SDupuie/esp32-weather-alarm-clock/docs/orbit-case/Orbit-Back-Mount-Mockup.png

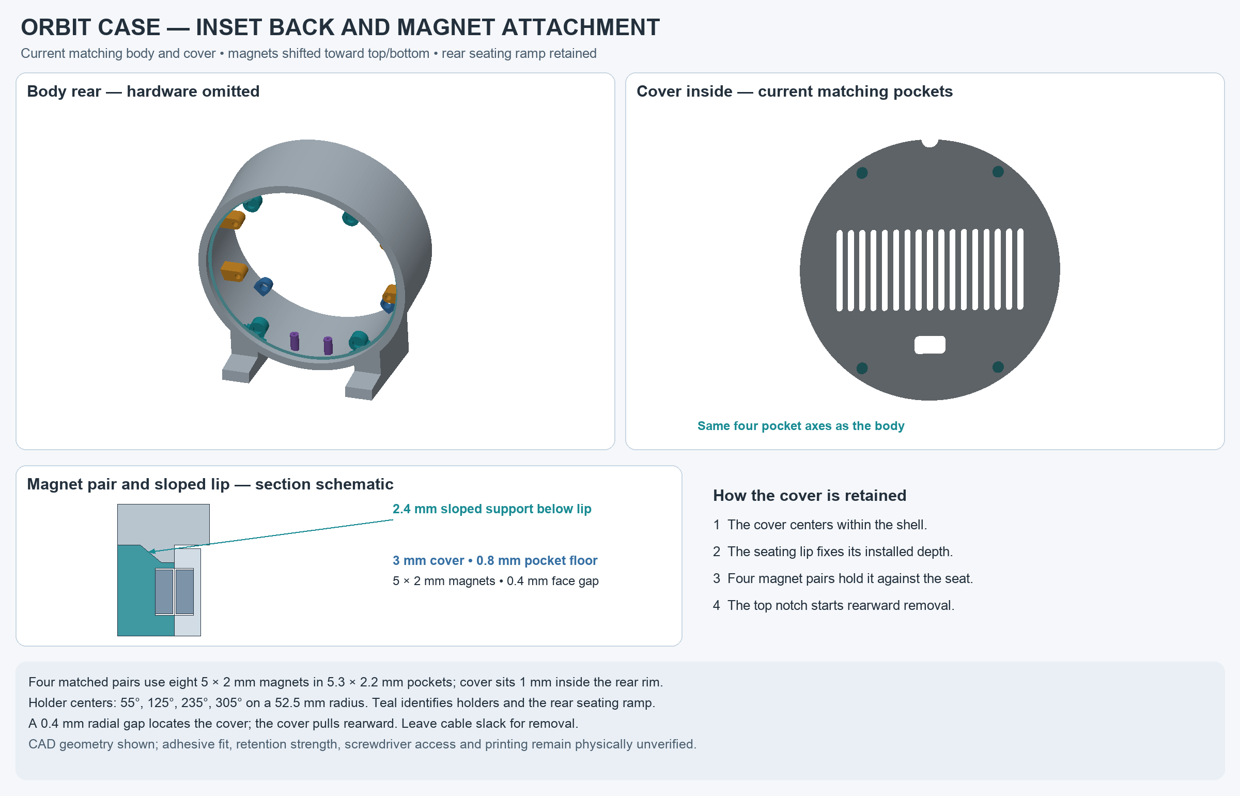
docs/orbit-case/Orbit-Back-Mount-Mockup.png
