SDupuie/esp32-weather-alarm-clock/docs/orbit-case/Orbit-Leg-Rear-Clearance-Detail.png

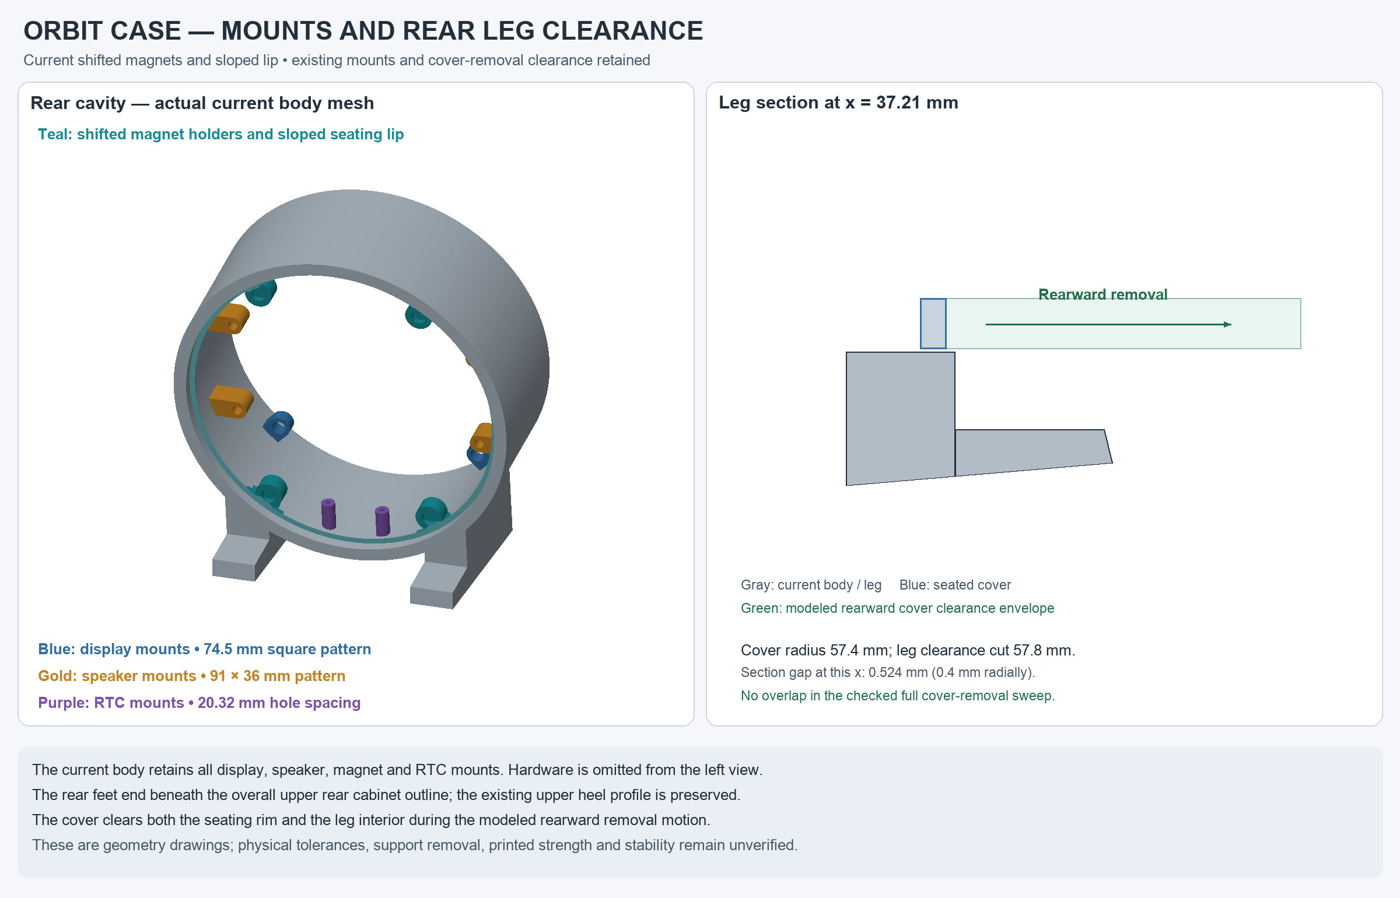
docs/orbit-case/Orbit-Leg-Rear-Clearance-Detail.png
