SDupuie/esp32-weather-alarm-clock/docs/orbit-case/Orbit-Magnet-Access-Detail.png

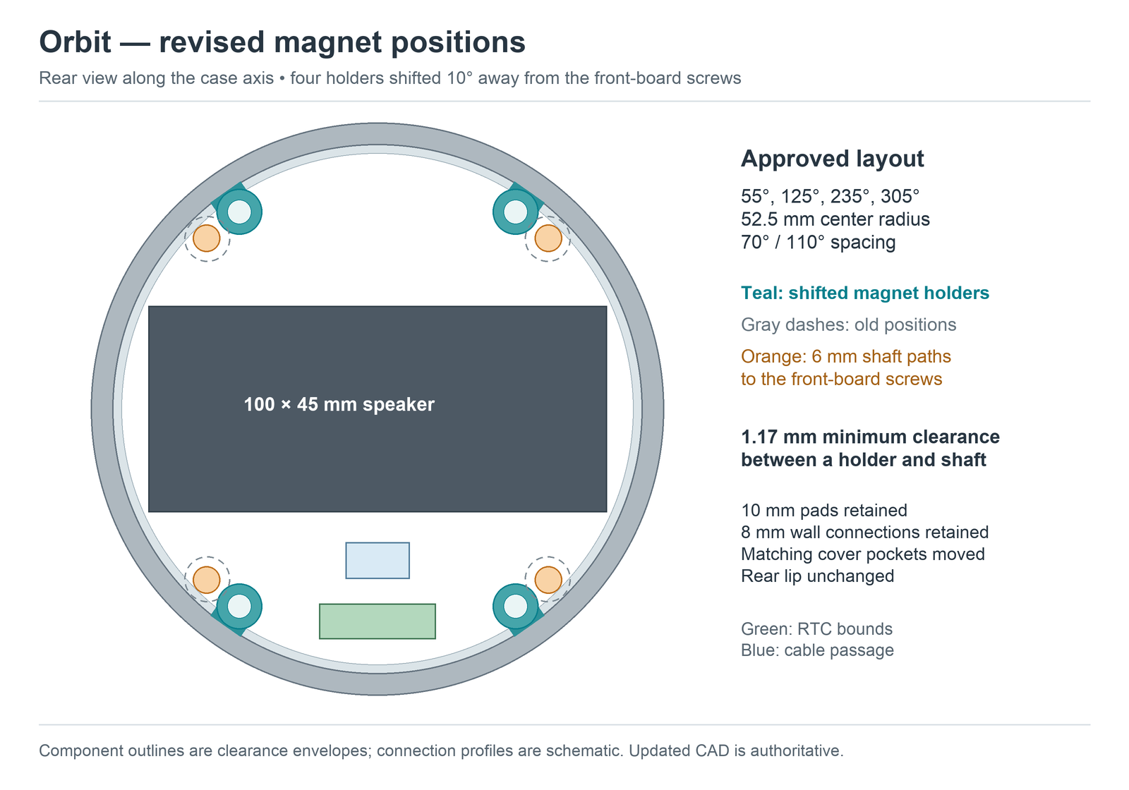
docs/orbit-case/Orbit-Magnet-Access-Detail.png
