SDupuie/esp32-weather-alarm-clock/docs/orbit-case/Orbit-Magnet-Pad-Detail.png

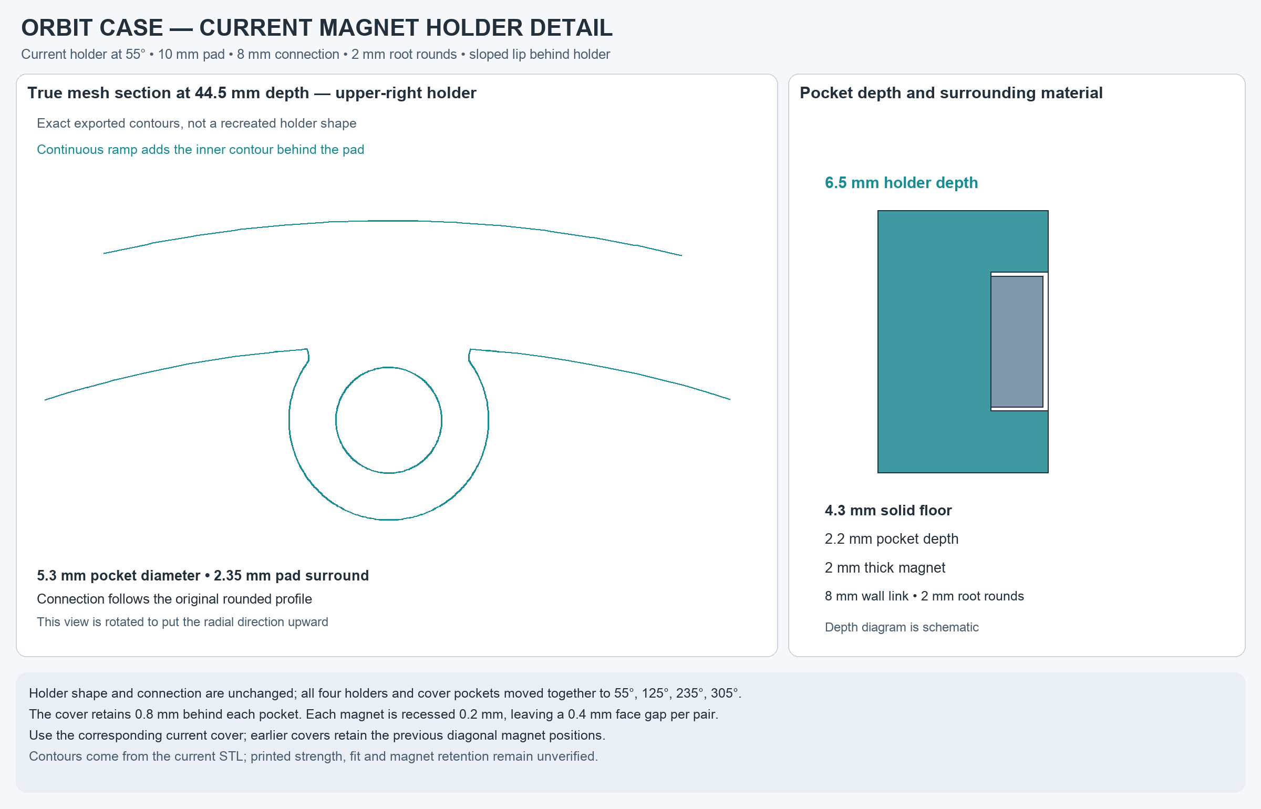
docs/orbit-case/Orbit-Magnet-Pad-Detail.png
