SDupuie/esp32-weather-alarm-clock/docs/orbit-case/Orbit-Rear-Lip-Detail.png

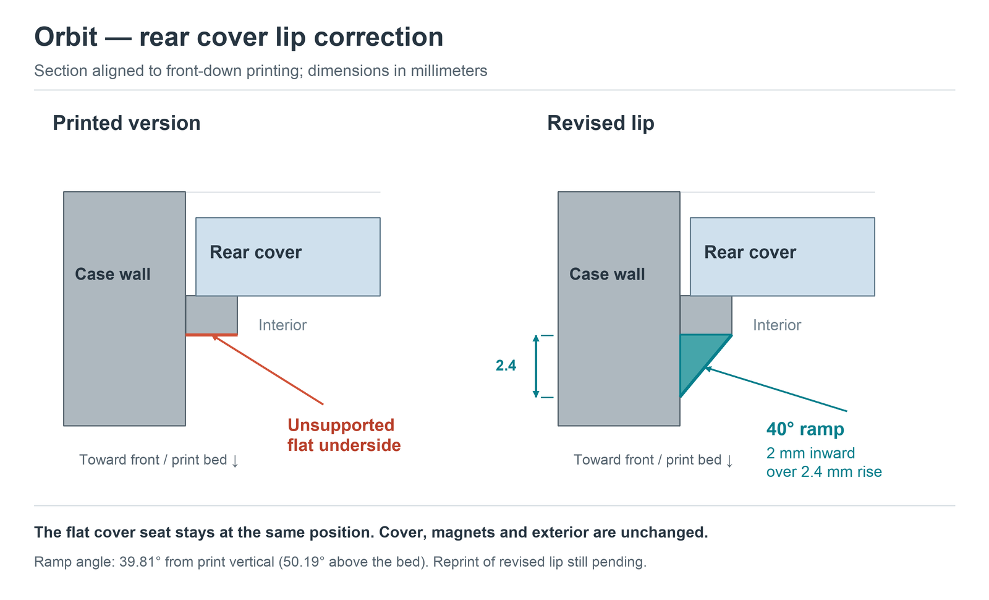
docs/orbit-case/Orbit-Rear-Lip-Detail.png
