SDupuie/esp32-weather-alarm-clock/docs/orbit-case/Orbit-Solid-Legs-Detail.png

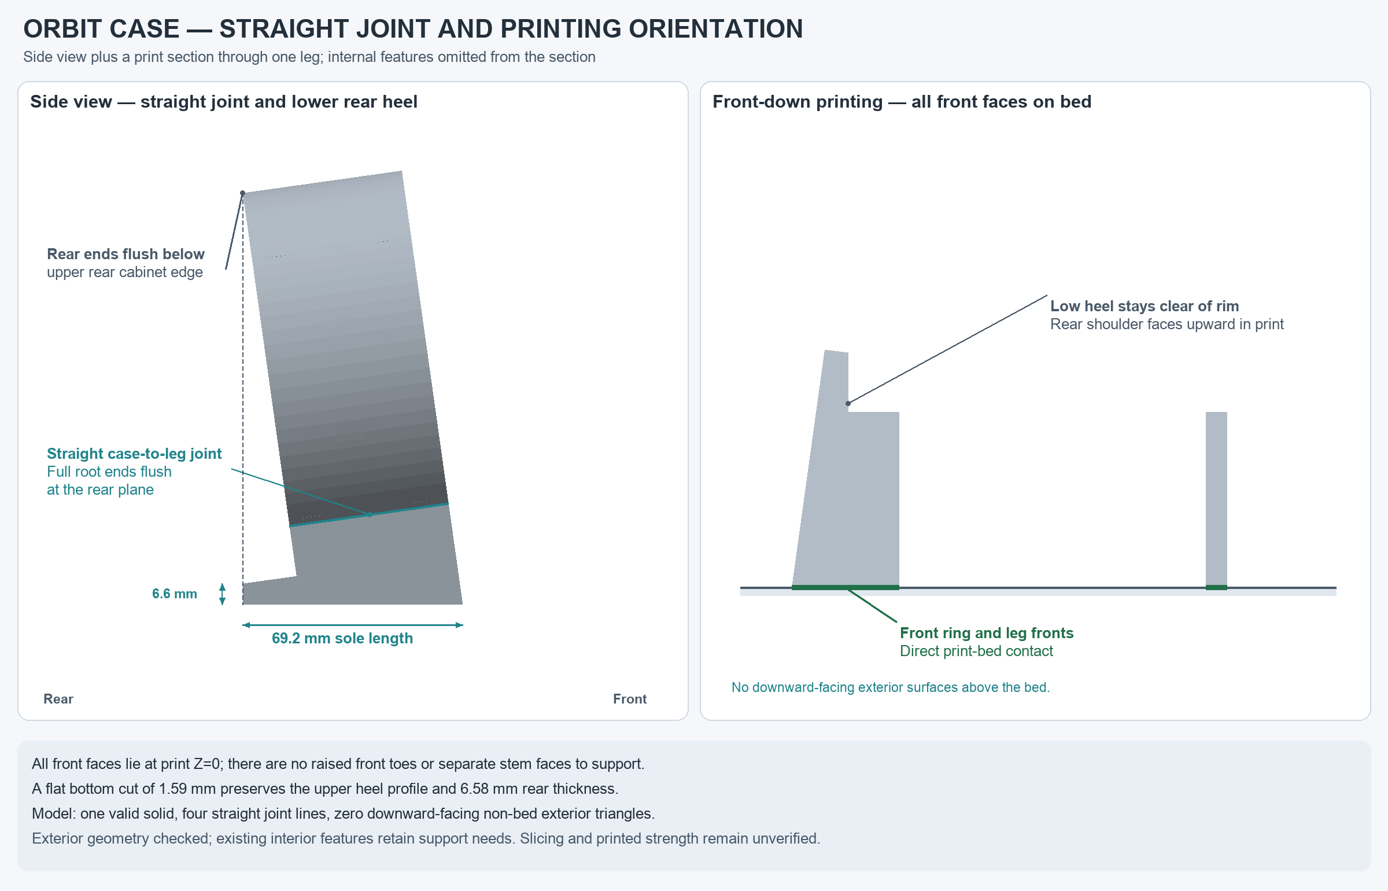
docs/orbit-case/Orbit-Solid-Legs-Detail.png
