SDupuie/esp32-weather-alarm-clock/mockups/assets/analog_dial_overlay_day.png

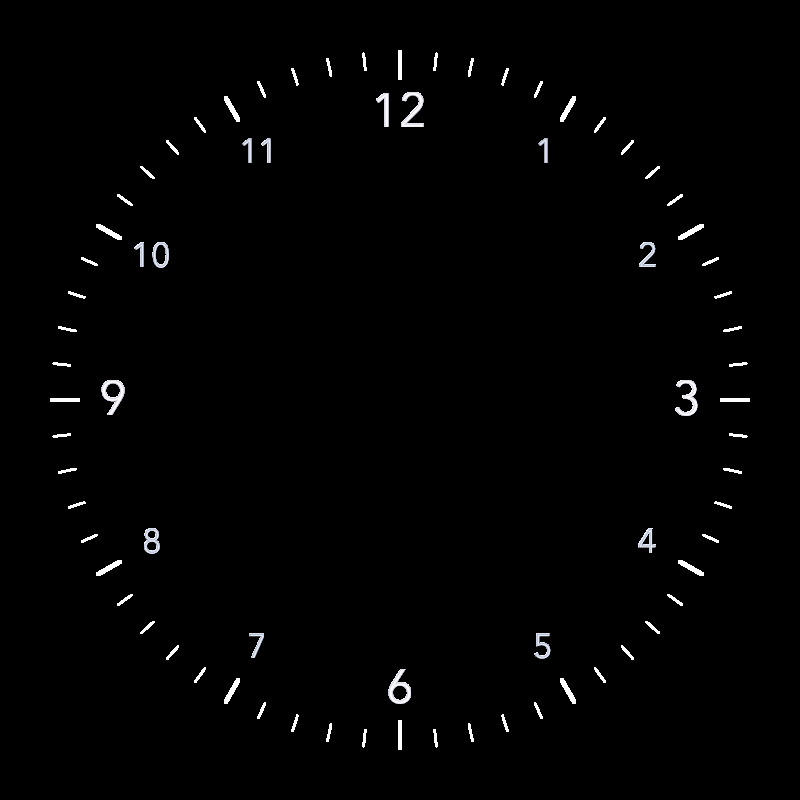
mockups/assets/analog_dial_overlay_day.png
