SDupuie/esp32-weather-alarm-clock/mockups/assets/analog_dial_overlay_night_tinted.png

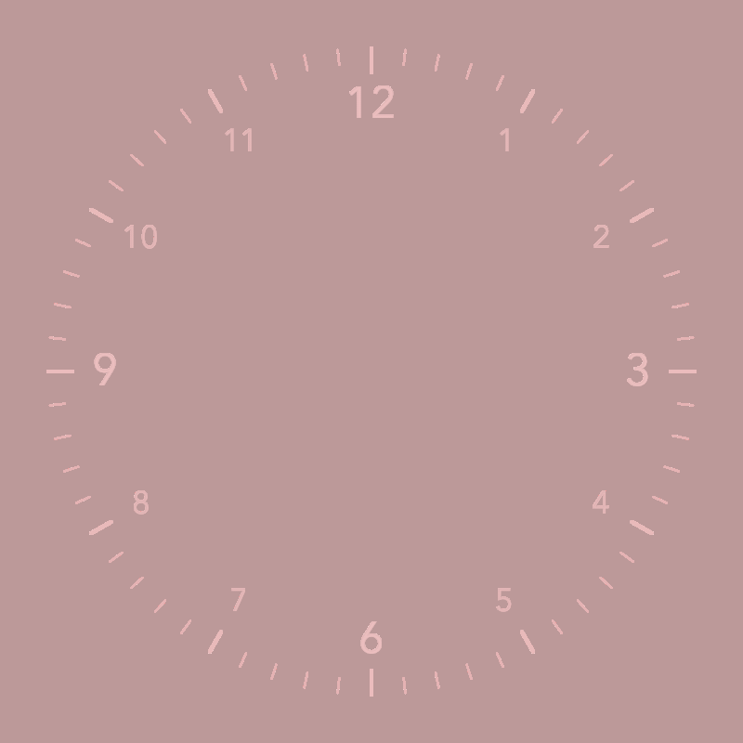
mockups/assets/analog_dial_overlay_night_tinted.png
