SDupuie/esp32-weather-alarm-clock/mockups/assets/analog_edge_indicator.png

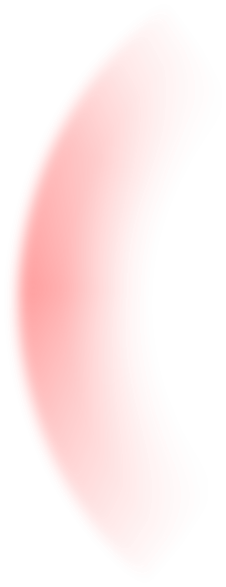
mockups/assets/analog_edge_indicator.png
