SDupuie/esp32-weather-alarm-clock/mockups/assets/analog_stage_day.png

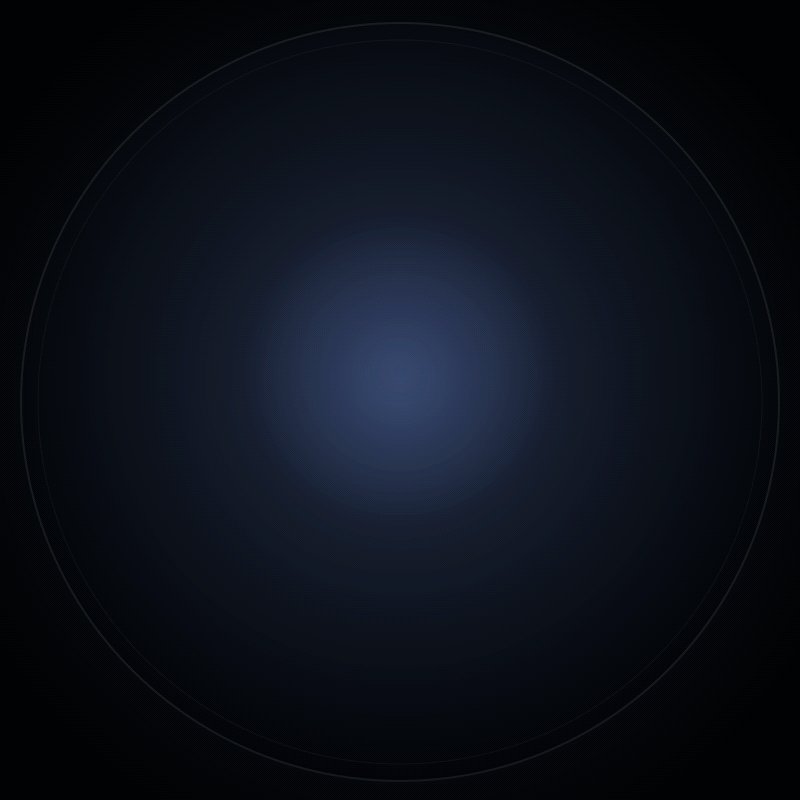
mockups/assets/analog_stage_day.png
