SDupuie/esp32-weather-alarm-clock/mockups/assets/analog_stage_day_tinted.png

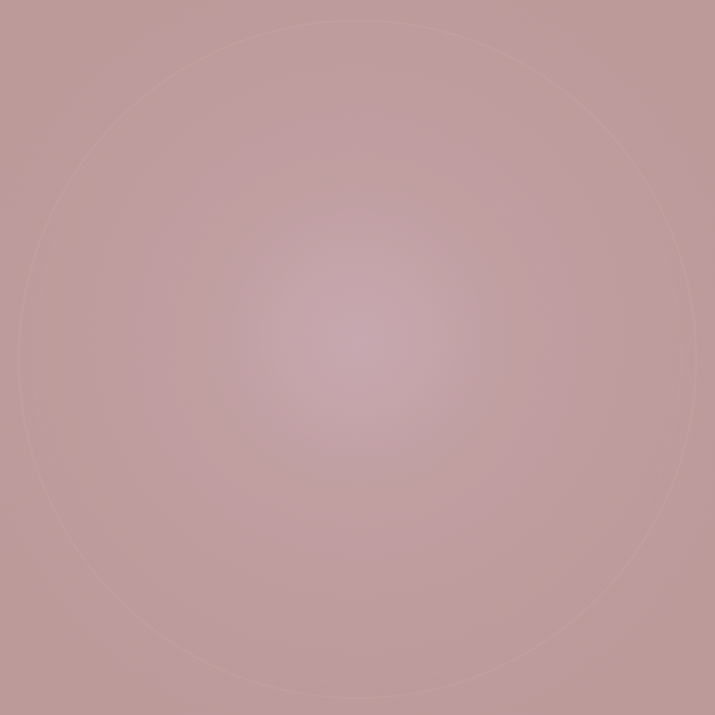
mockups/assets/analog_stage_day_tinted.png
