SDupuie/esp32-weather-alarm-clock/mockups/assets/conditions_edge_indicator.png

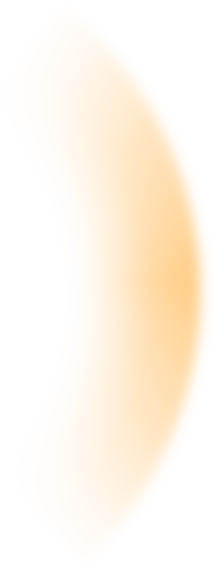
mockups/assets/conditions_edge_indicator.png
