SDupuie/esp32-weather-alarm-clock/mockups/assets/digital_stage_night.png

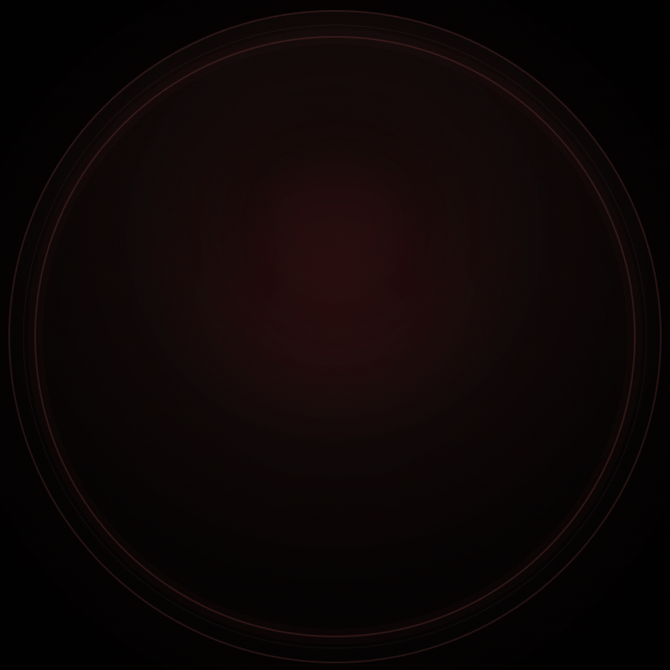
mockups/assets/digital_stage_night.png
