SDupuie/esp32-weather-alarm-clock/mockups/assets/forecast_tomorrow_frame_night.png

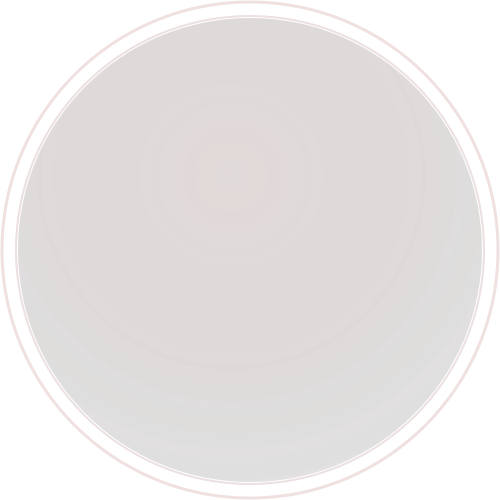
mockups/assets/forecast_tomorrow_frame_night.png
