SDupuie/esp32-weather-alarm-clock/mockups/gallery.png

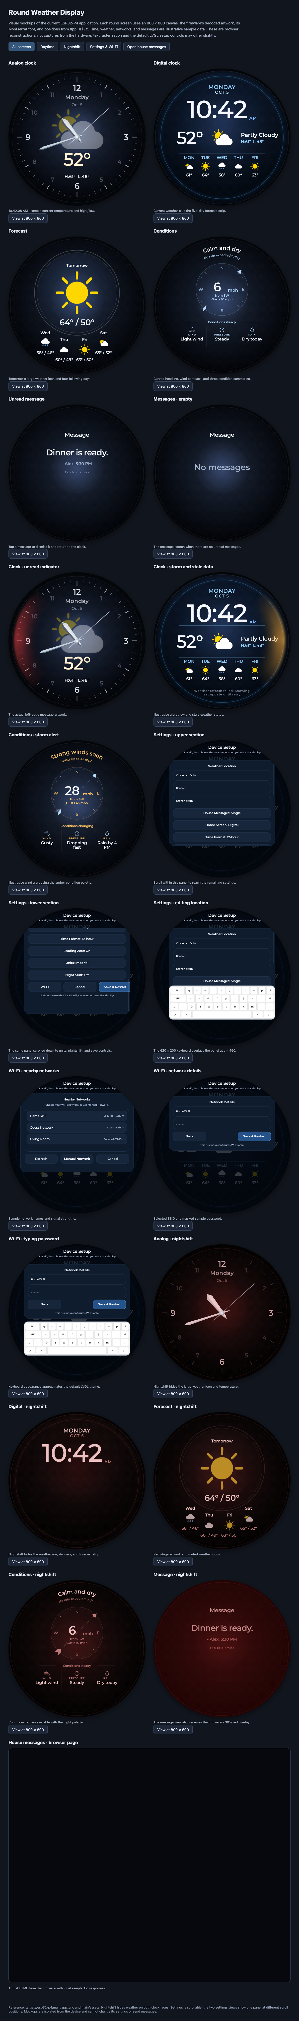
mockups/gallery.png
