SDupuie/esp32-weather-alarm-clock/mockups/overview.png

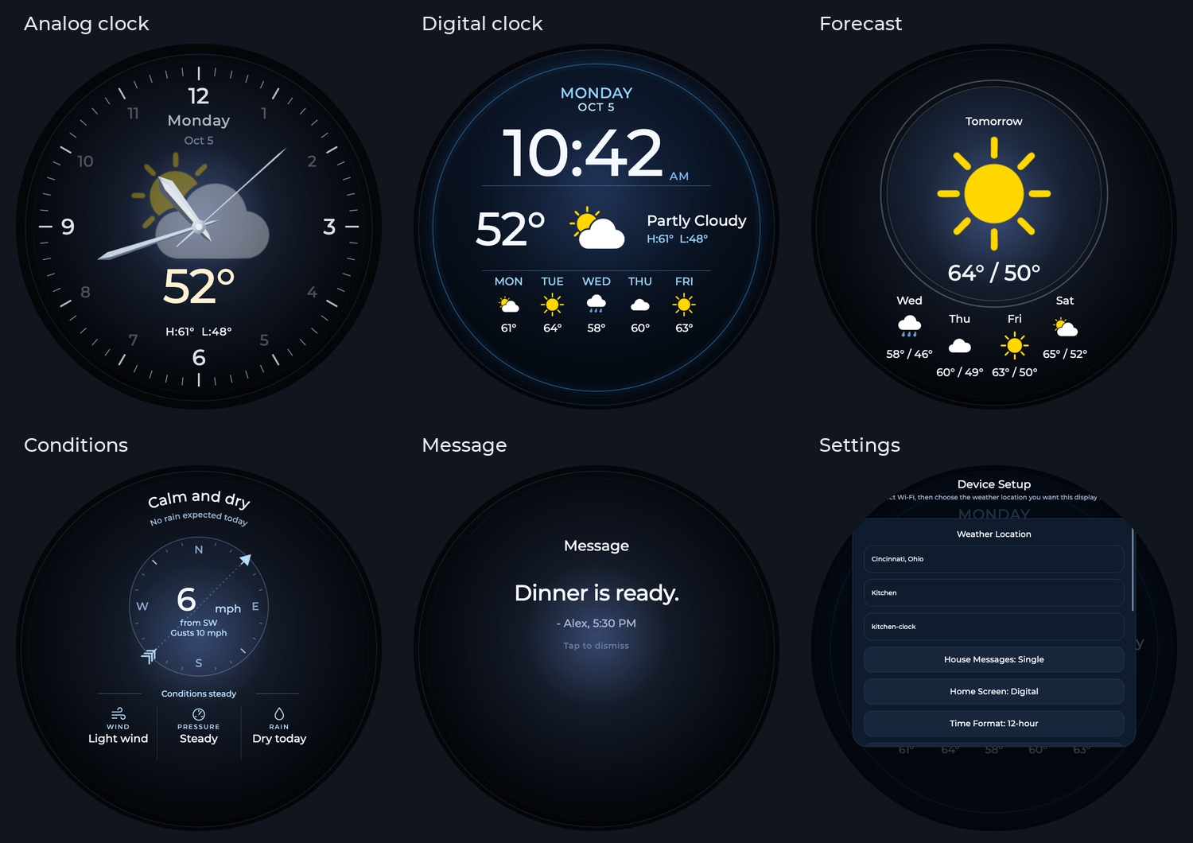
mockups/overview.png
