SDupuie/esp32-weather-alarm-clock/mockups/screens/alarm-analog-night.png

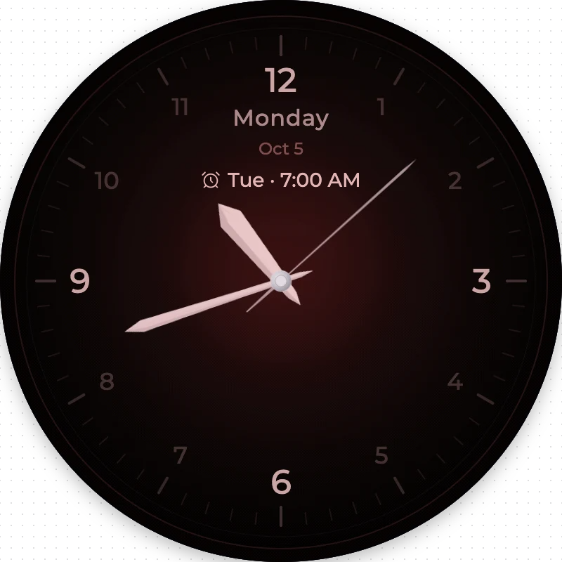
mockups/screens/alarm-analog-night.png
