SDupuie/esp32-weather-alarm-clock/mockups/screens/alarm-conditions-night.png

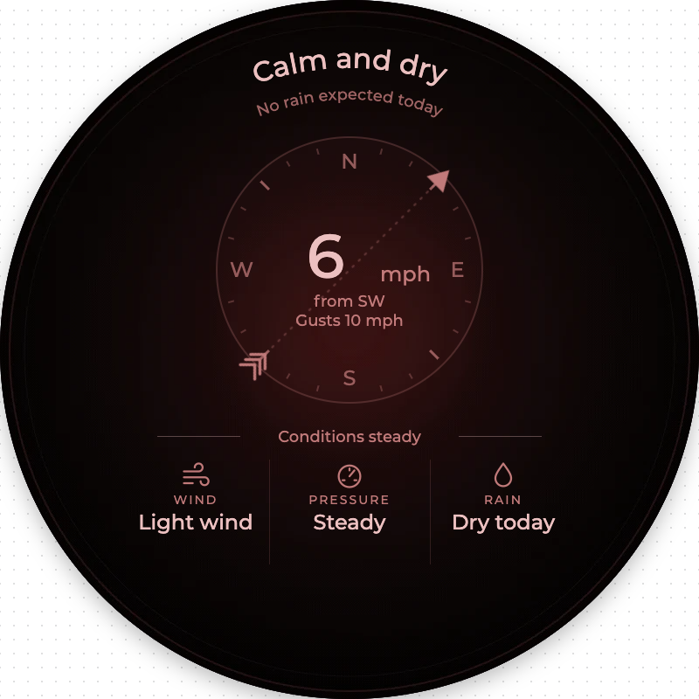
mockups/screens/alarm-conditions-night.png
