SDupuie/esp32-weather-alarm-clock/mockups/screens/alarm-device-night.png

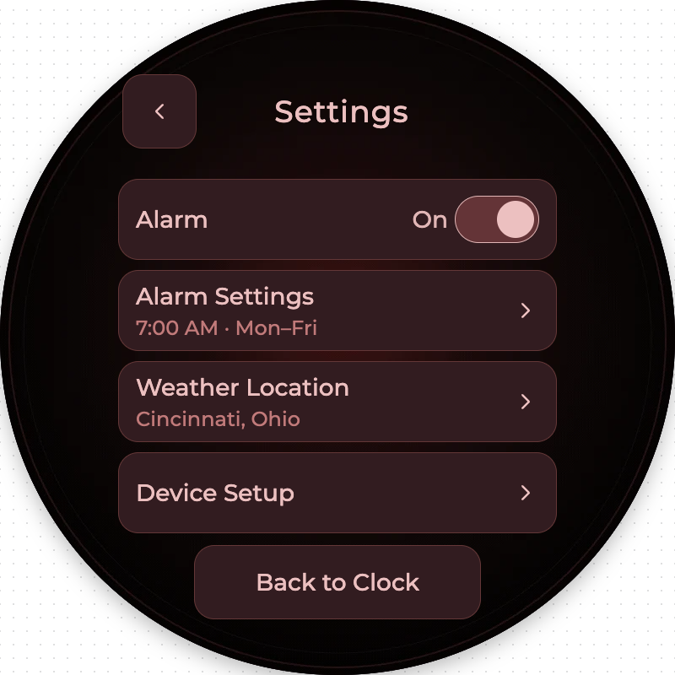
mockups/screens/alarm-device-night.png
