SDupuie/esp32-weather-alarm-clock/mockups/screens/alarm-device-settings-night.png

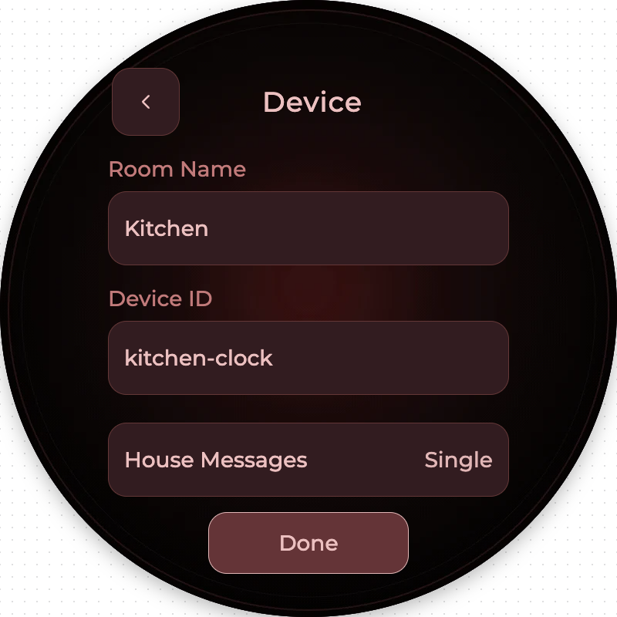
mockups/screens/alarm-device-settings-night.png
