SDupuie/esp32-weather-alarm-clock/mockups/screens/alarm-digital.png

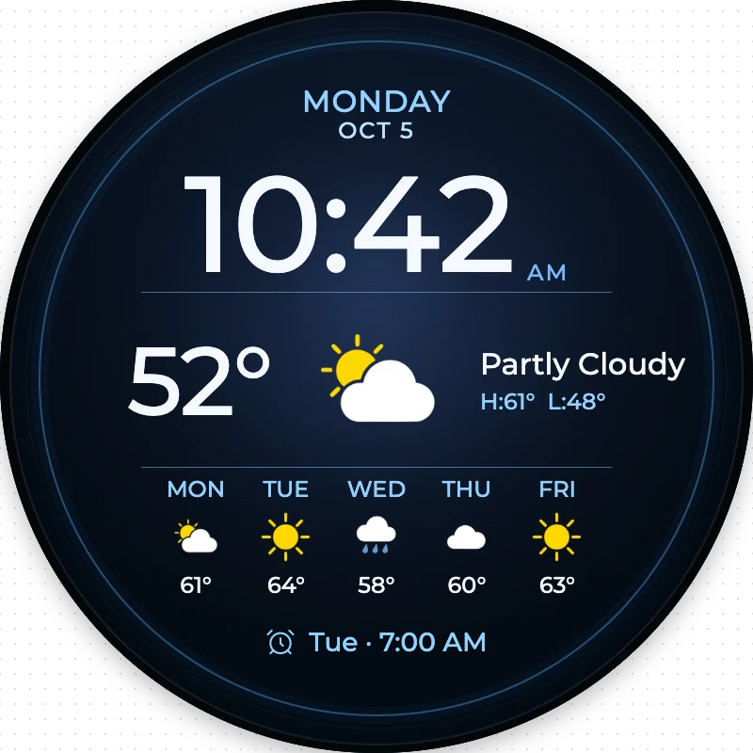
mockups/screens/alarm-digital.png
