SDupuie/esp32-weather-alarm-clock/mockups/screens/alarm-display-settings-night.png

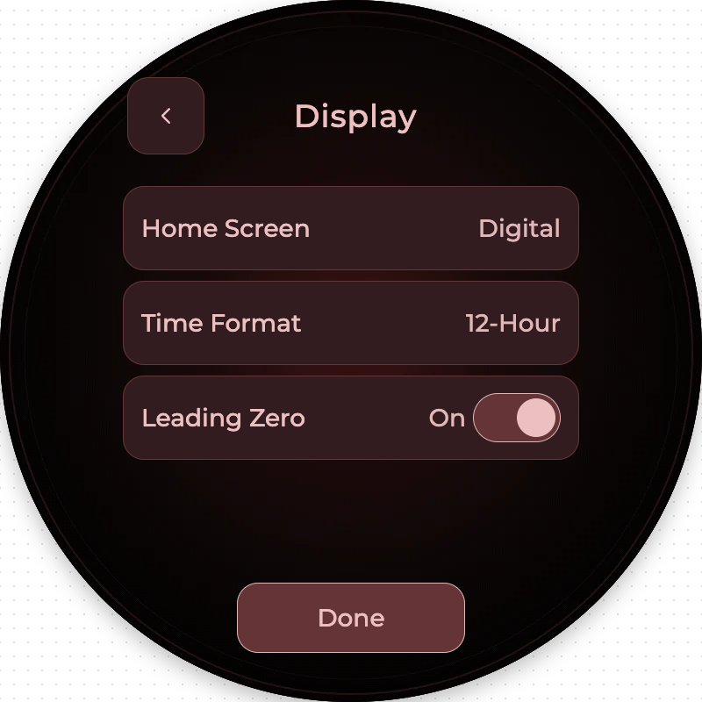
mockups/screens/alarm-display-settings-night.png
