SDupuie/esp32-weather-alarm-clock/mockups/screens/alarm-forecast-night.png

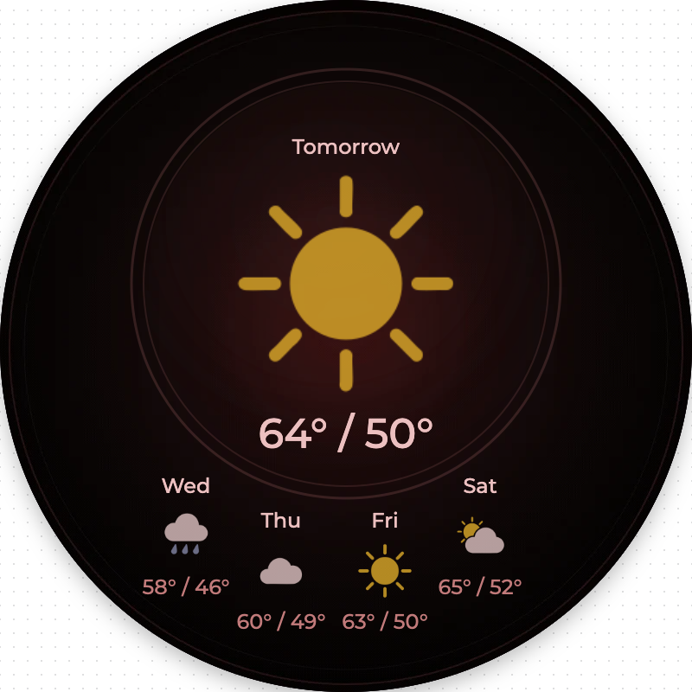
mockups/screens/alarm-forecast-night.png
