SDupuie/esp32-weather-alarm-clock/mockups/screens/alarm-missed-analog.png

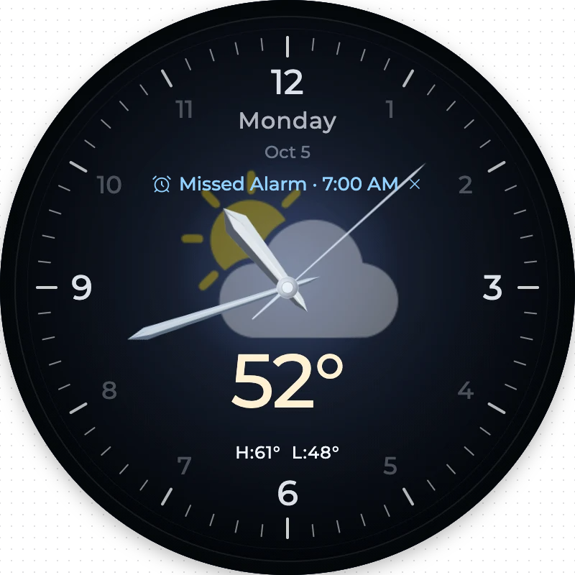
mockups/screens/alarm-missed-analog.png
