SDupuie/esp32-weather-alarm-clock/mockups/screens/alarm-network-details-night.png

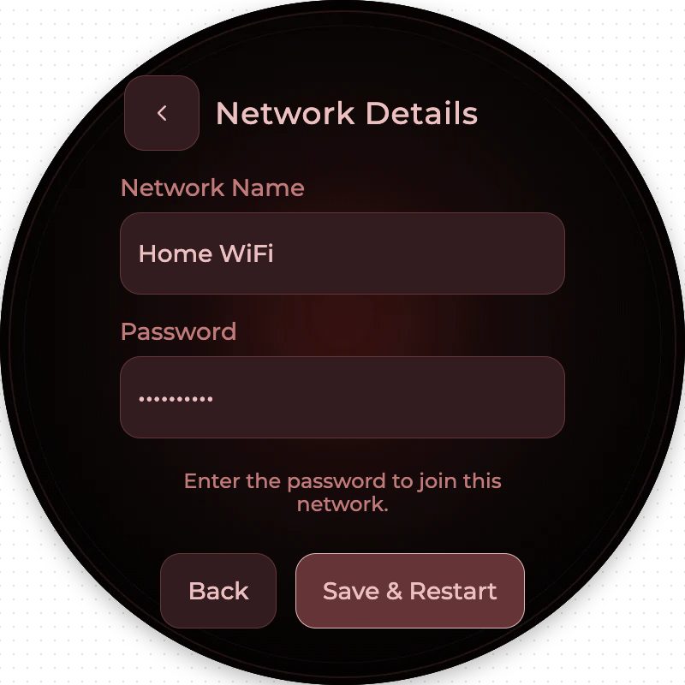
mockups/screens/alarm-network-details-night.png
