SDupuie/esp32-weather-alarm-clock/mockups/screens/alarm-network-keyboard-night.png

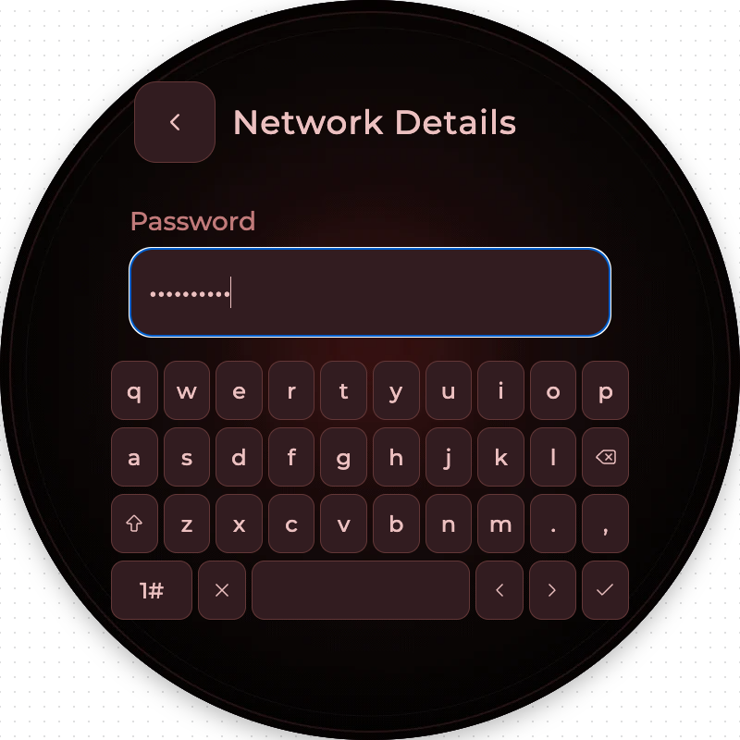
mockups/screens/alarm-network-keyboard-night.png
