SDupuie/esp32-weather-alarm-clock/mockups/screens/alarm-network-keyboard-symbols.png

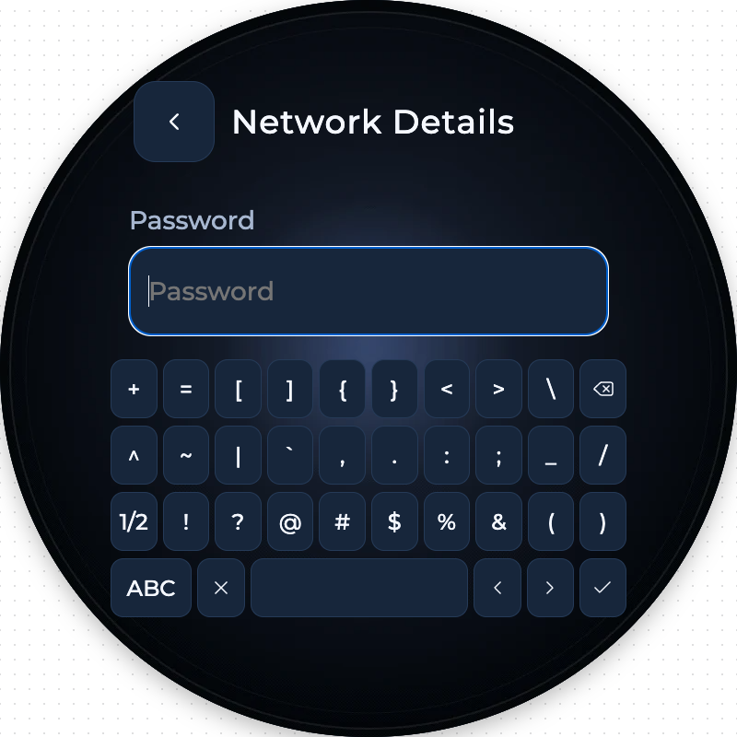
mockups/screens/alarm-network-keyboard-symbols.png
