SDupuie/esp32-weather-alarm-clock/mockups/screens/alarm-night-brightness-night.png

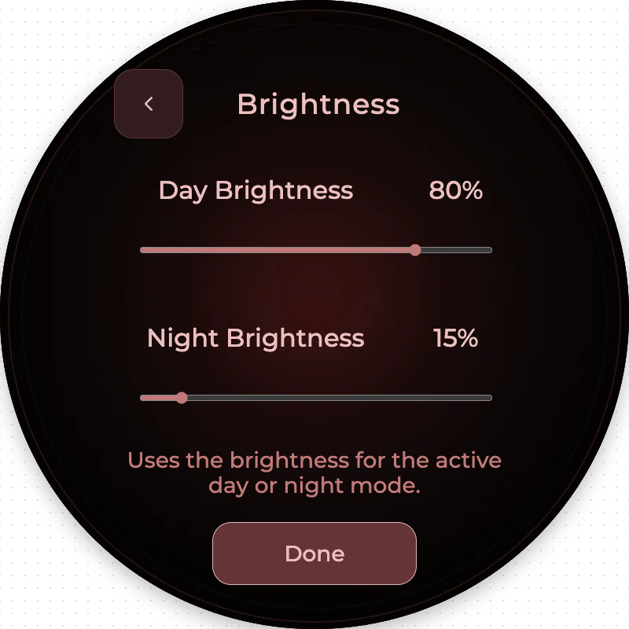
mockups/screens/alarm-night-brightness-night.png
