SDupuie/esp32-weather-alarm-clock/mockups/screens/alarm-night-fixed-night.png

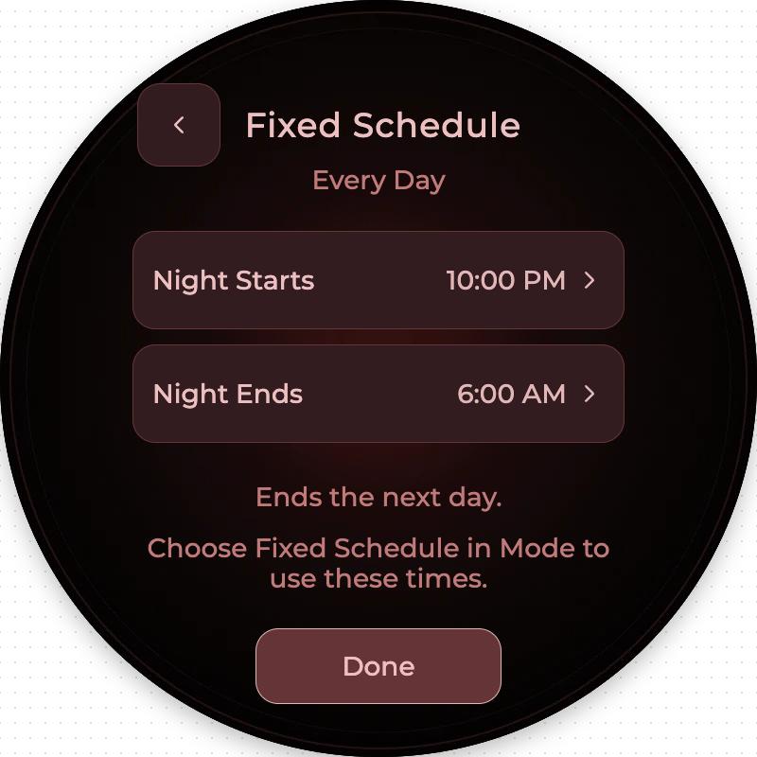
mockups/screens/alarm-night-fixed-night.png
