SDupuie/esp32-weather-alarm-clock/mockups/screens/alarm-night-mode-night.png

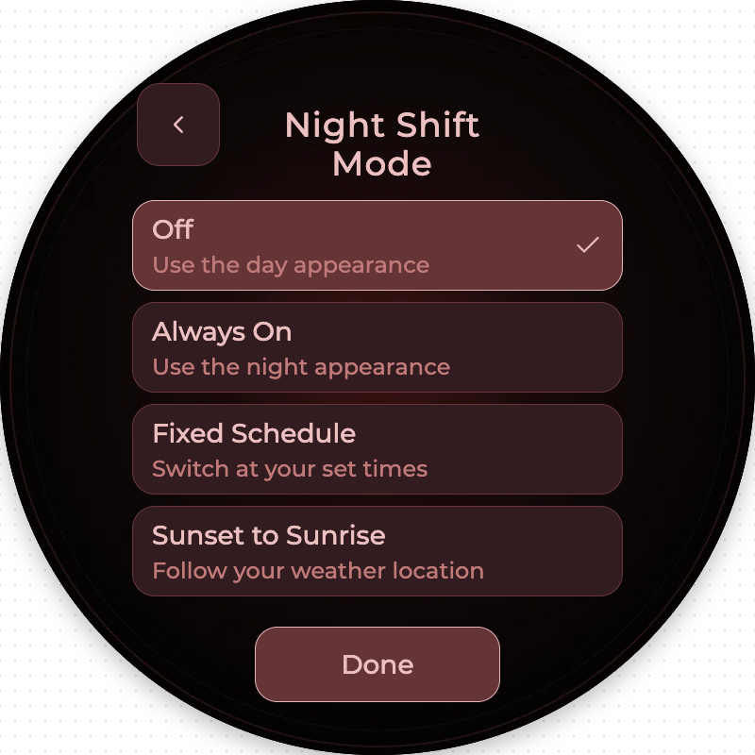
mockups/screens/alarm-night-mode-night.png
