SDupuie/esp32-weather-alarm-clock/mockups/screens/alarm-night-offset-night.png

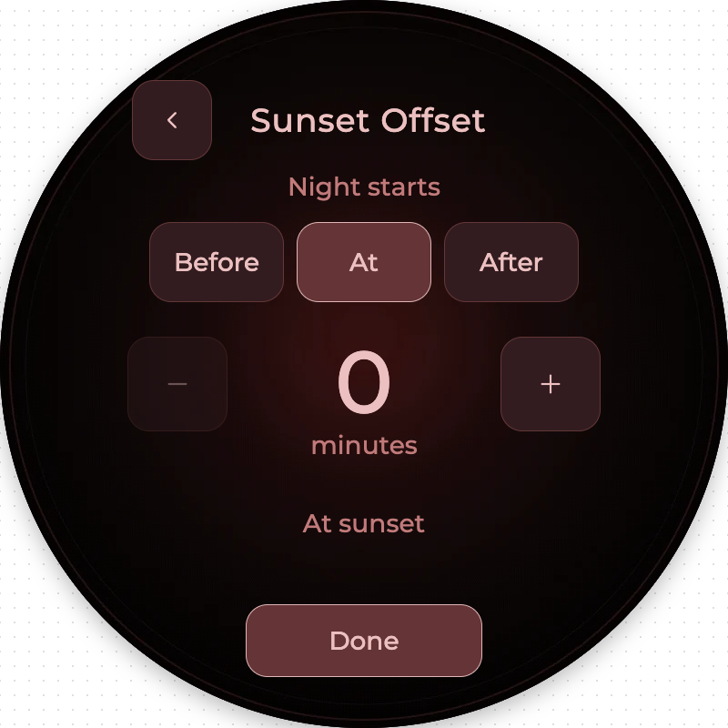
mockups/screens/alarm-night-offset-night.png
