SDupuie/esp32-weather-alarm-clock/mockups/screens/alarm-night-shift-night.png

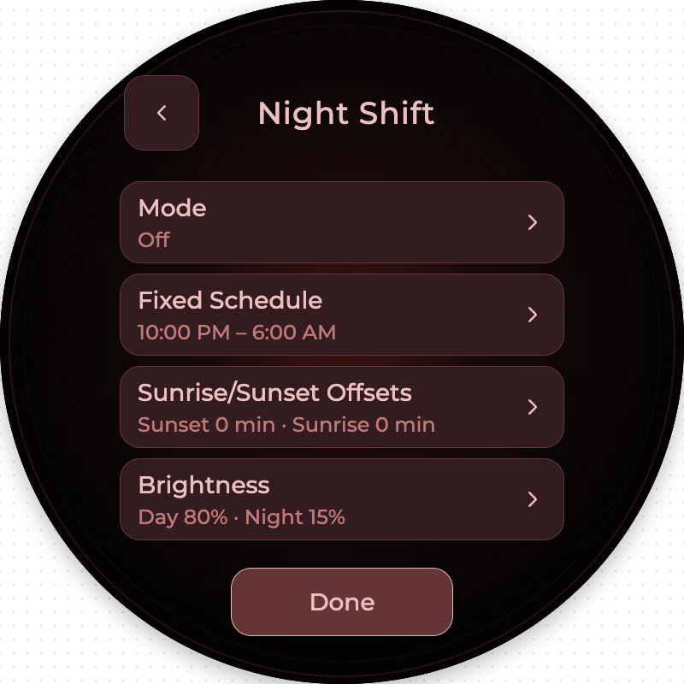
mockups/screens/alarm-night-shift-night.png
