SDupuie/esp32-weather-alarm-clock/mockups/screens/alarm-night-solar-night.png

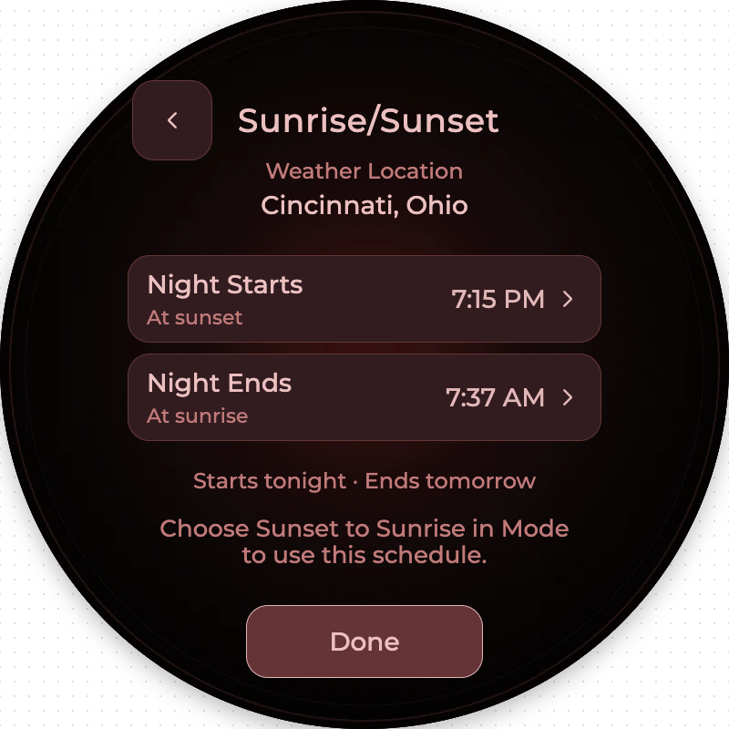
mockups/screens/alarm-night-solar-night.png
