SDupuie/esp32-weather-alarm-clock/mockups/screens/alarm-night-solar-no-location.png

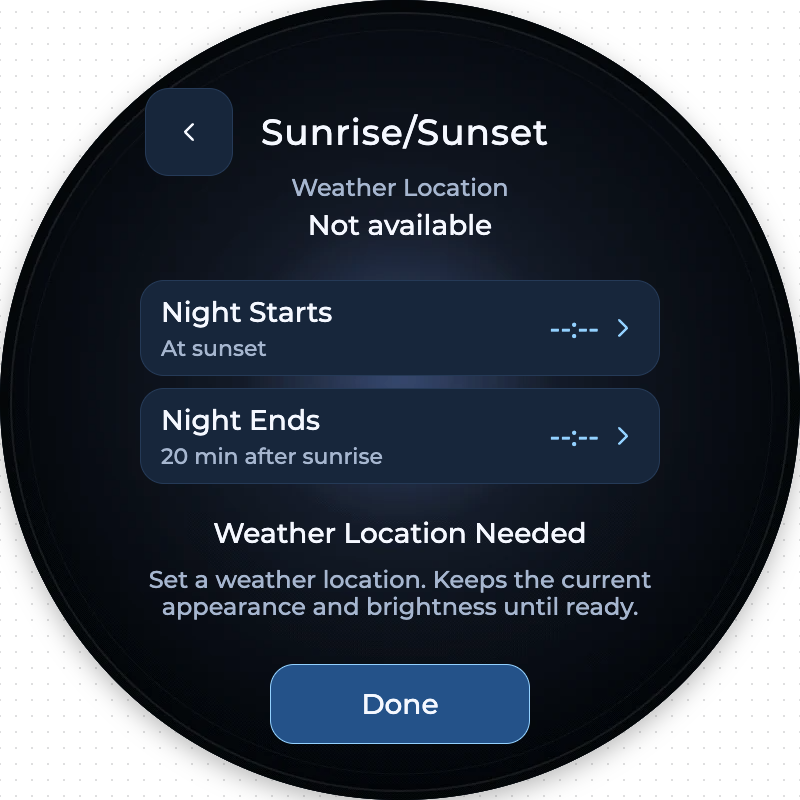
mockups/screens/alarm-night-solar-no-location.png
