SDupuie/esp32-weather-alarm-clock/mockups/screens/alarm-night-start-time-night.png

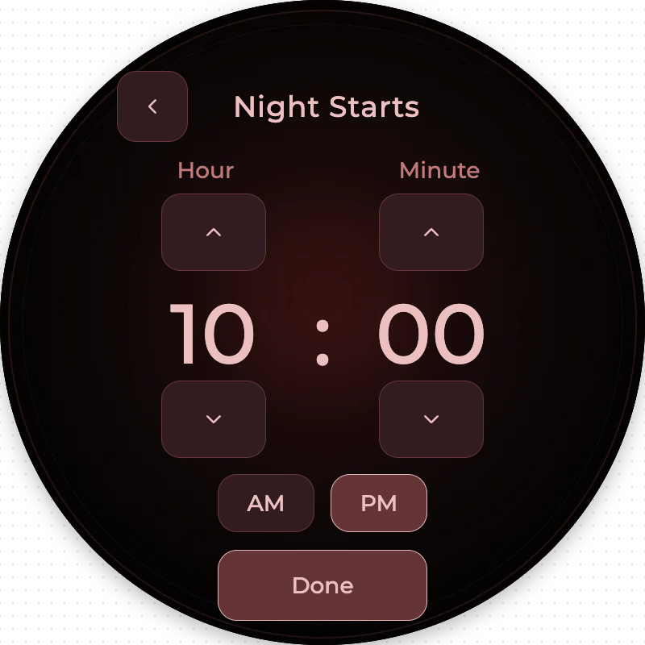
mockups/screens/alarm-night-start-time-night.png
