SDupuie/esp32-weather-alarm-clock/mockups/screens/alarm-night-start-time.png

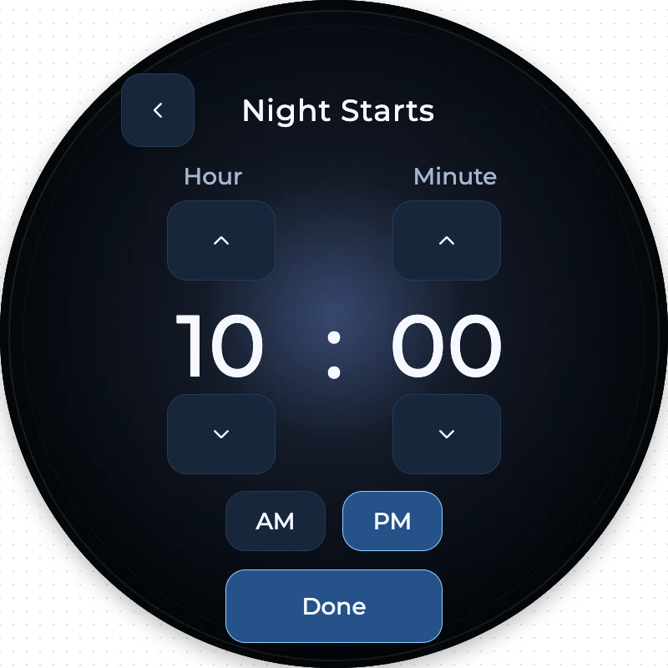
mockups/screens/alarm-night-start-time.png
