SDupuie/esp32-weather-alarm-clock/mockups/screens/alarm-repeat.png

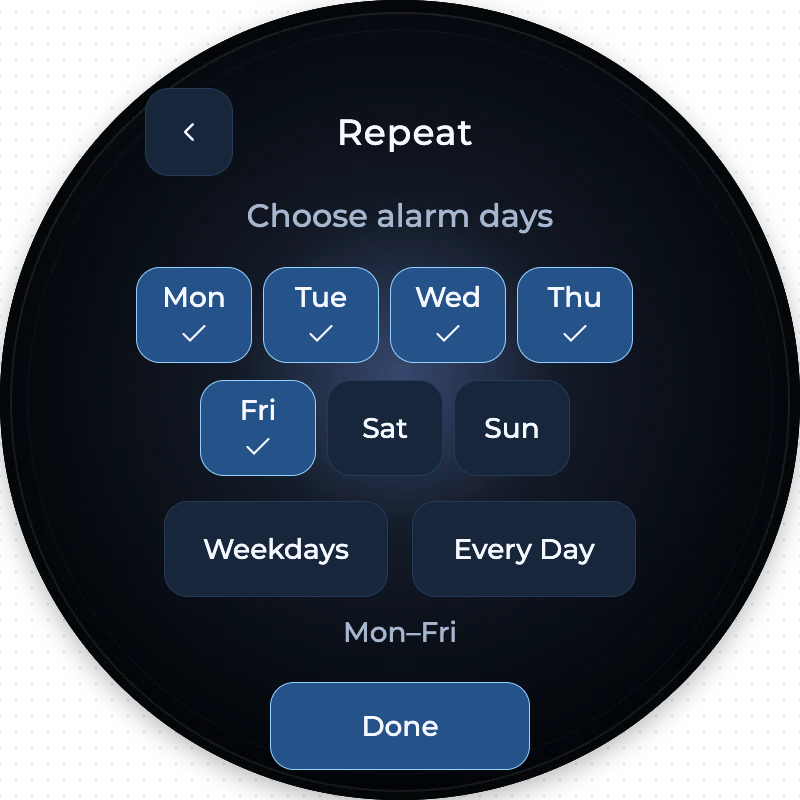
mockups/screens/alarm-repeat.png
