SDupuie/esp32-weather-alarm-clock/mockups/screens/alarm-settings-night.png

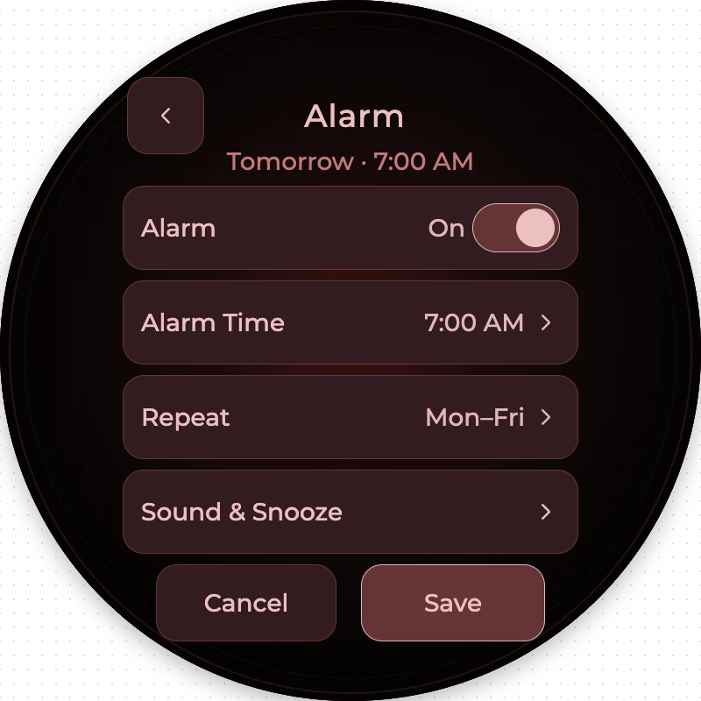
mockups/screens/alarm-settings-night.png
