SDupuie/esp32-weather-alarm-clock/mockups/screens/alarm-sound-snooze-night.png

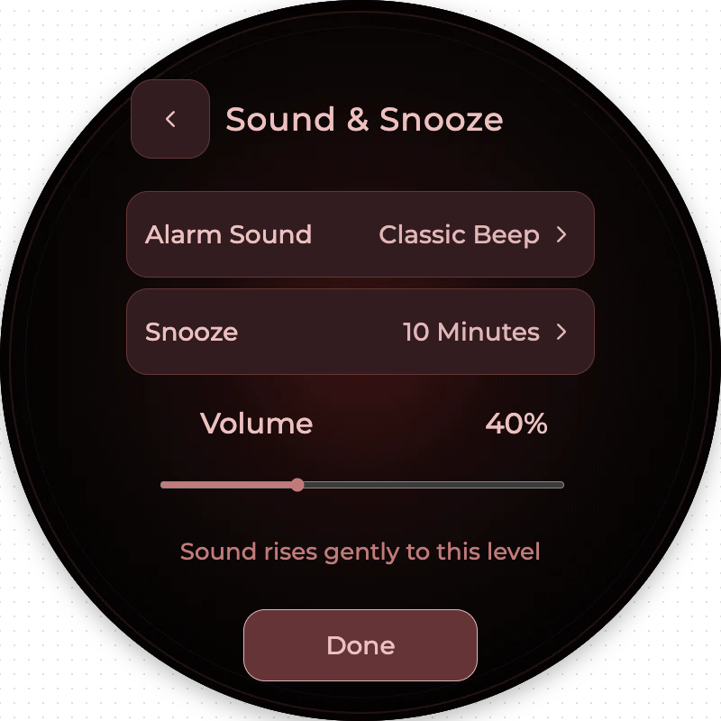
mockups/screens/alarm-sound-snooze-night.png
