SDupuie/esp32-weather-alarm-clock/mockups/screens/alarm-weather-checking-keyboard-night.png

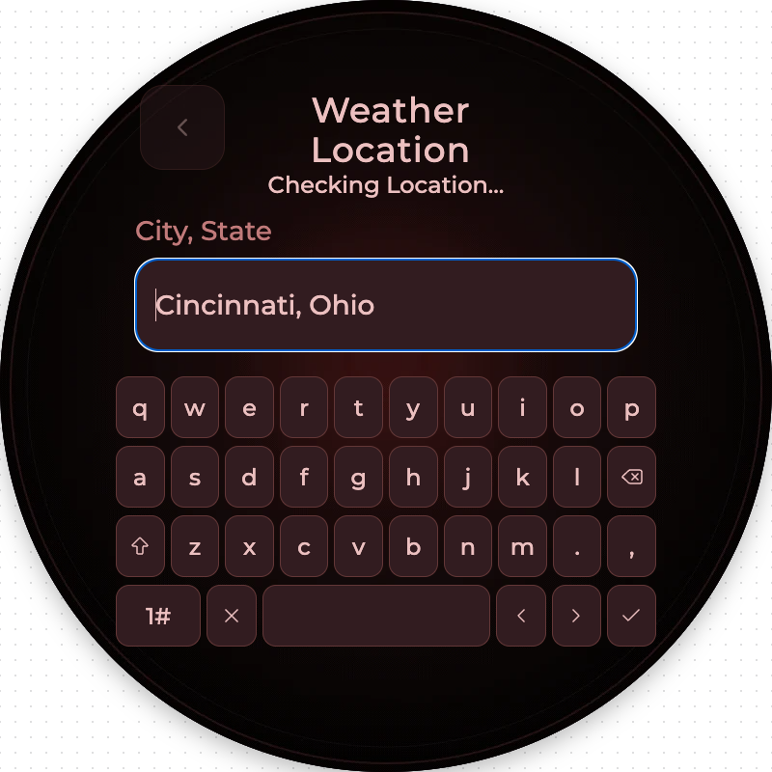
mockups/screens/alarm-weather-checking-keyboard-night.png
