SDupuie/esp32-weather-alarm-clock/mockups/screens/alarm-weather-checking-night.png

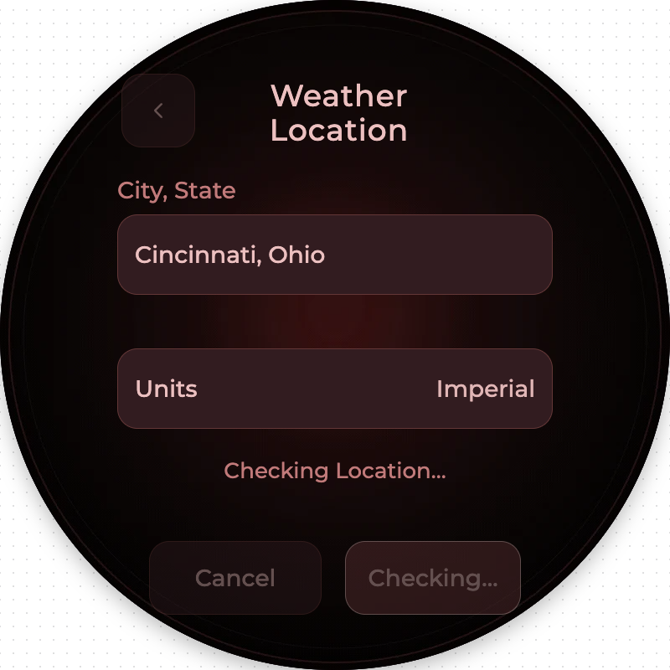
mockups/screens/alarm-weather-checking-night.png
