SDupuie/esp32-weather-alarm-clock/mockups/screens/alarm-weather-checking.png

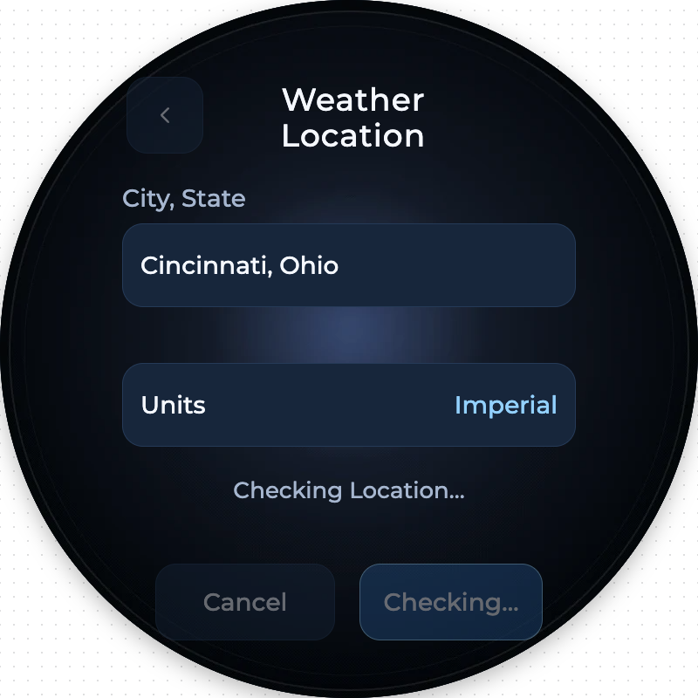
mockups/screens/alarm-weather-checking.png
