SDupuie/esp32-weather-alarm-clock/mockups/screens/alert.png

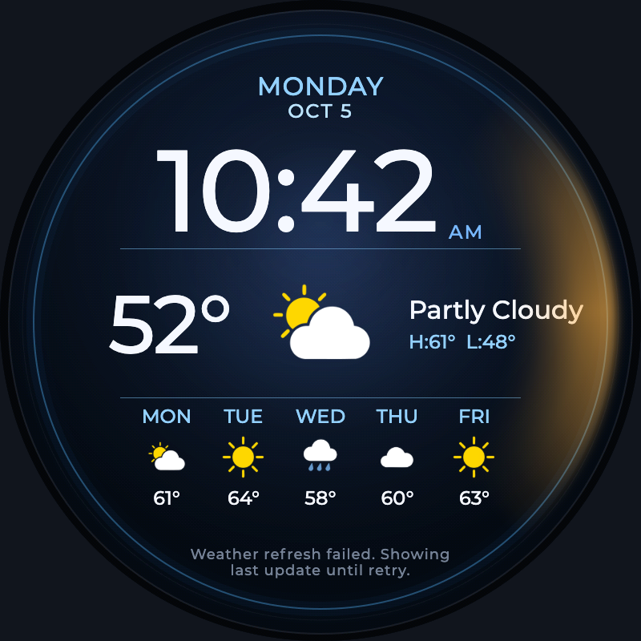
mockups/screens/alert.png
