SDupuie/esp32-weather-alarm-clock/mockups/screens/analog-night.png

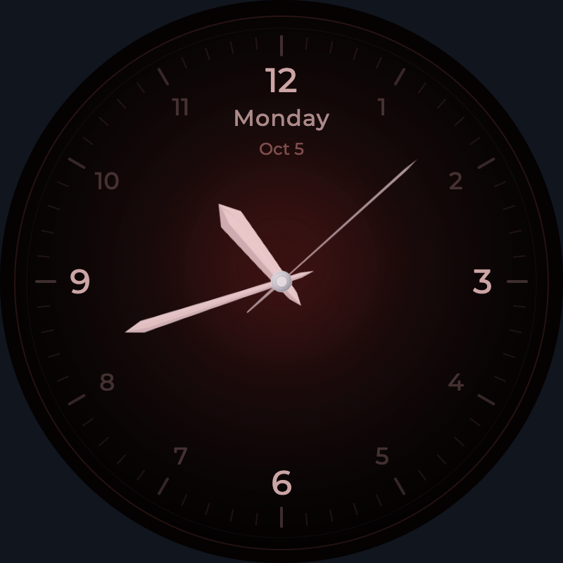
mockups/screens/analog-night.png
