SDupuie/esp32-weather-alarm-clock/mockups/screens/analog.png

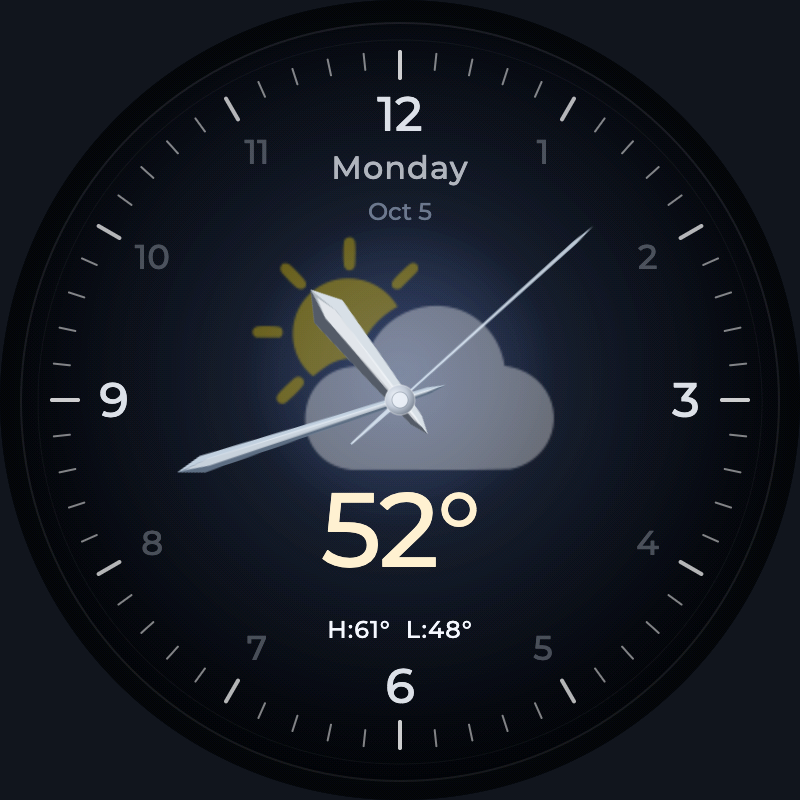
mockups/screens/analog.png
