SDupuie/esp32-weather-alarm-clock/mockups/screens/conditions-night.png

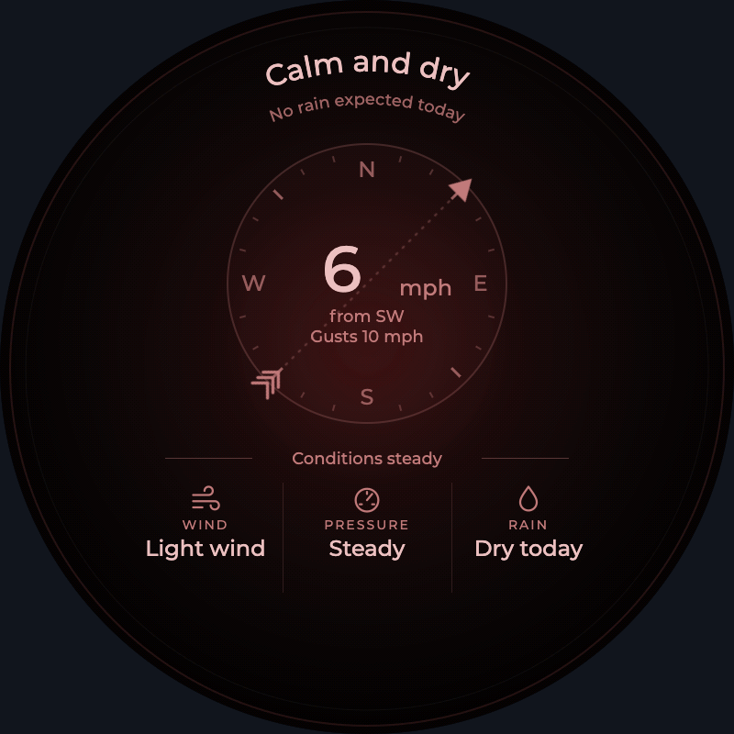
mockups/screens/conditions-night.png
