SDupuie/esp32-weather-alarm-clock/mockups/screens/conditions.png

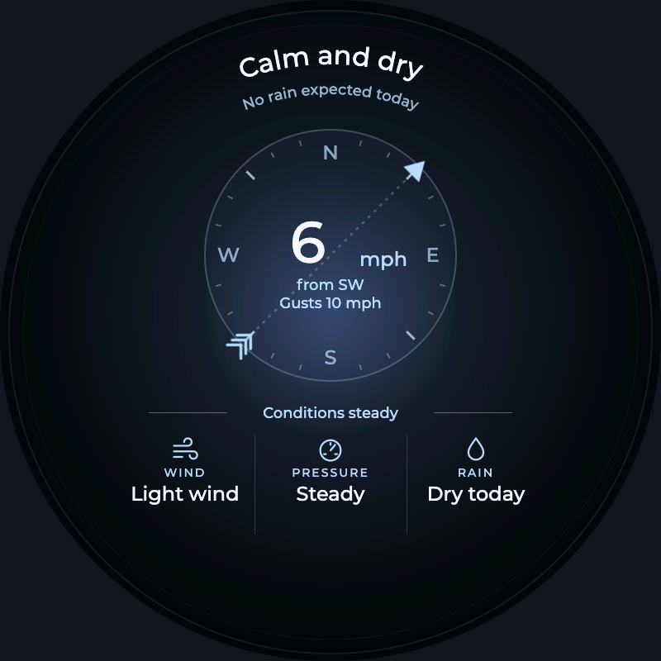
mockups/screens/conditions.png
