SDupuie/esp32-weather-alarm-clock/mockups/screens/credentials.png

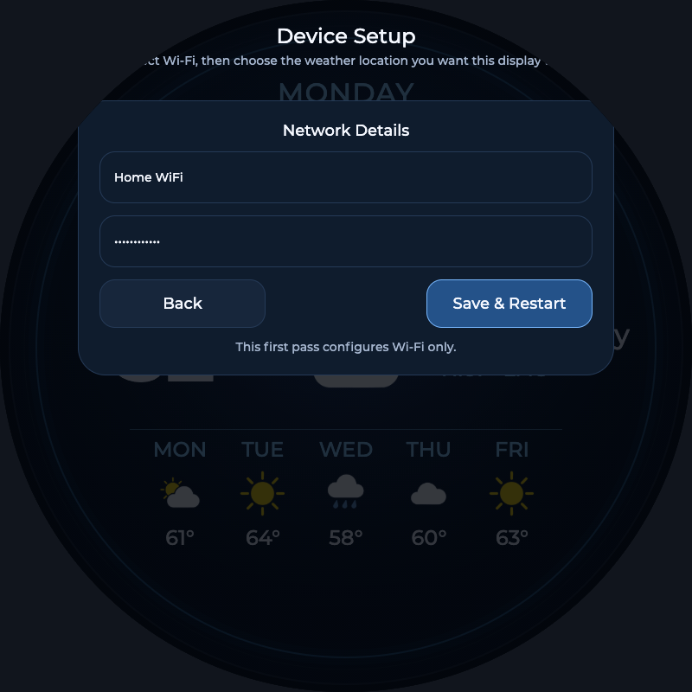
mockups/screens/credentials.png
