SDupuie/esp32-weather-alarm-clock/mockups/screens/digital-night.png

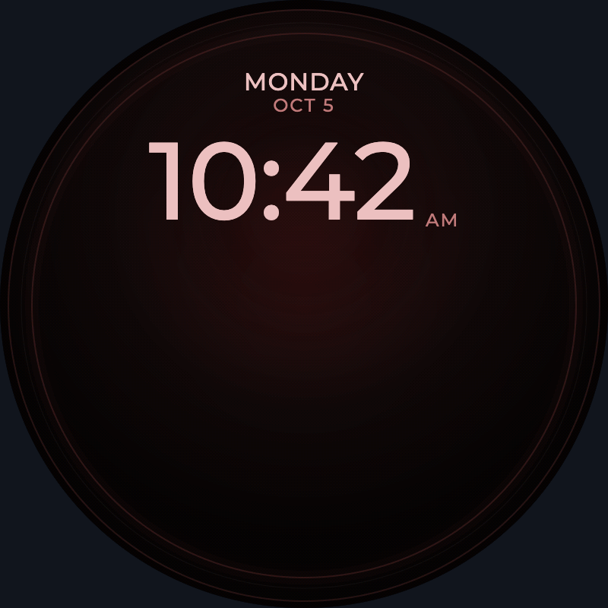
mockups/screens/digital-night.png
