SDupuie/esp32-weather-alarm-clock/mockups/screens/digital.png

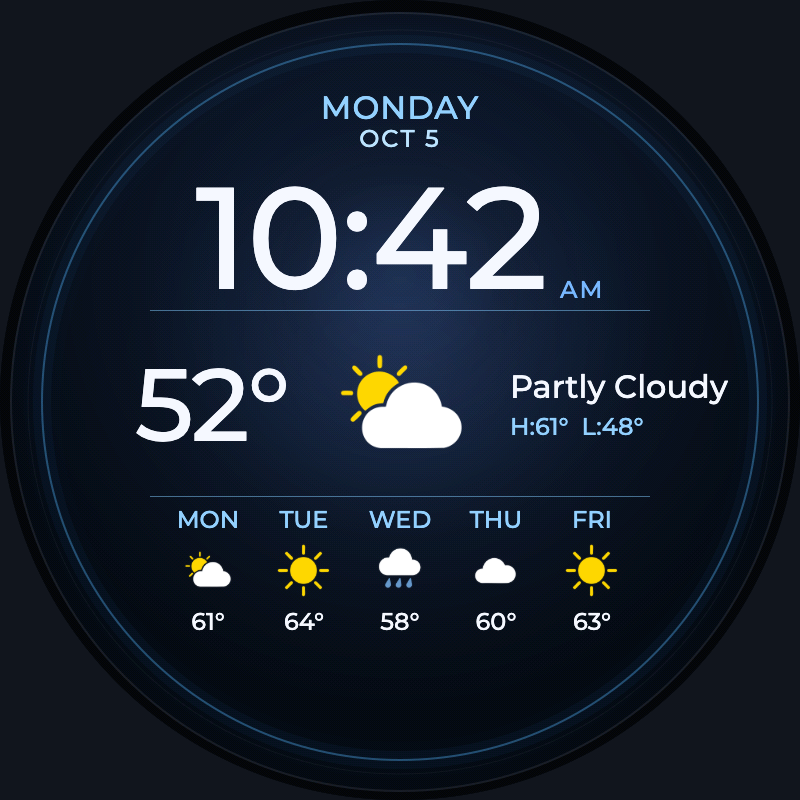
mockups/screens/digital.png
