SDupuie/esp32-weather-alarm-clock/mockups/screens/empty.png

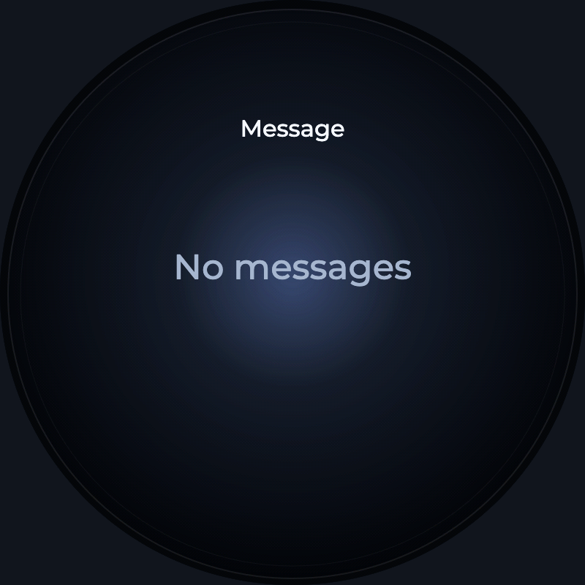
mockups/screens/empty.png
