SDupuie/esp32-weather-alarm-clock/mockups/screens/forecast-night.png

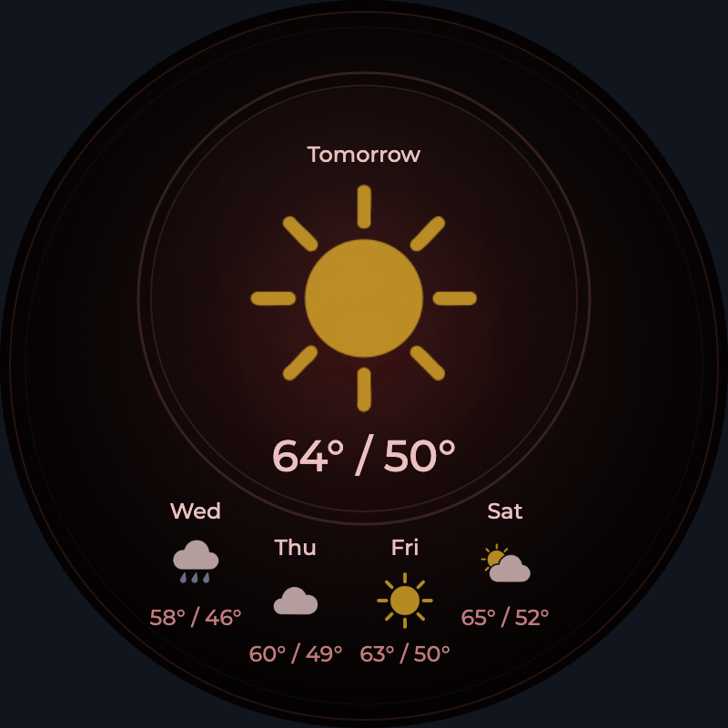
mockups/screens/forecast-night.png
