SDupuie/esp32-weather-alarm-clock/mockups/screens/forecast.png

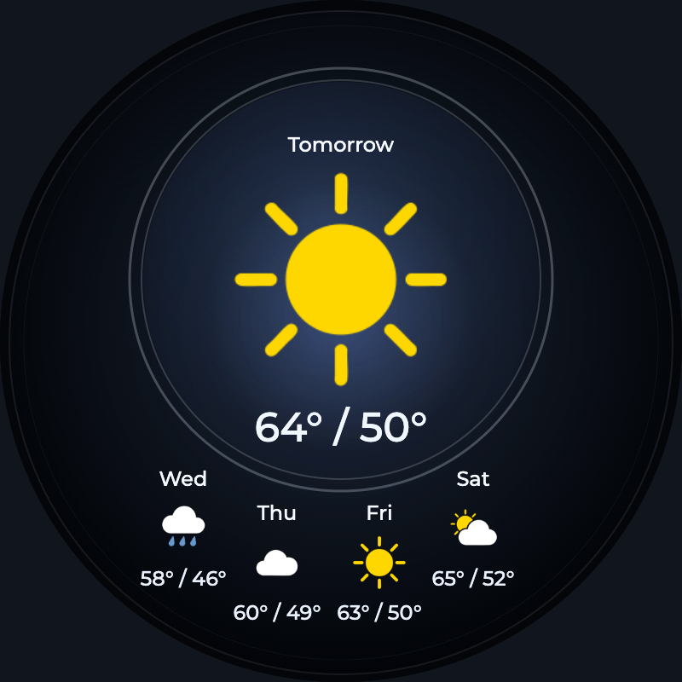
mockups/screens/forecast.png
