SDupuie/esp32-weather-alarm-clock/mockups/screens/house-messages.png

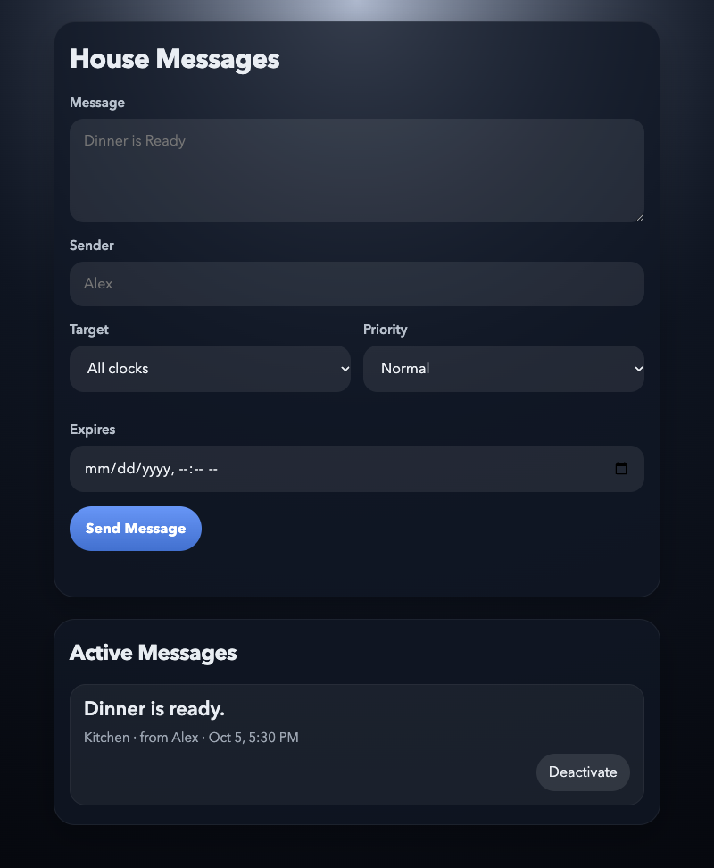
mockups/screens/house-messages.png
