SDupuie/esp32-weather-alarm-clock/mockups/screens/location-keyboard.png

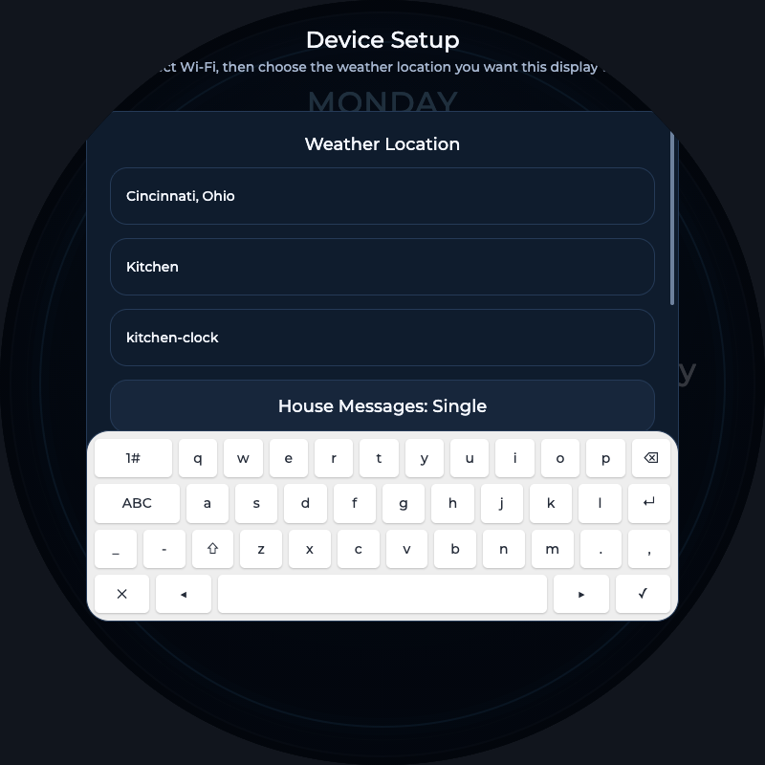
mockups/screens/location-keyboard.png
