SDupuie/esp32-weather-alarm-clock/mockups/screens/message-night.png

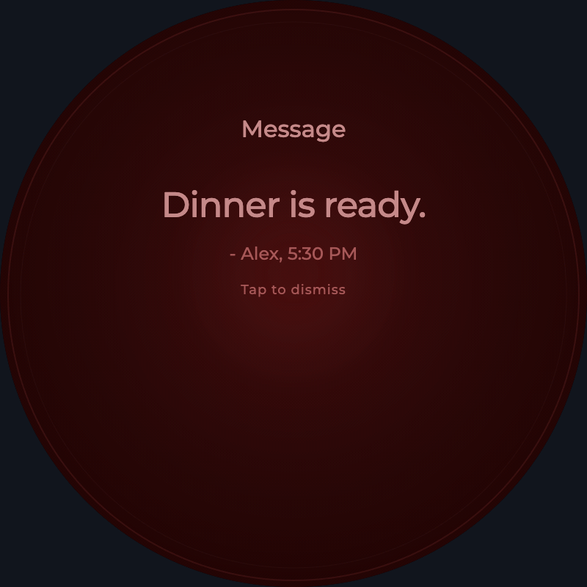
mockups/screens/message-night.png
