SDupuie/esp32-weather-alarm-clock/mockups/screens/password-keyboard.png

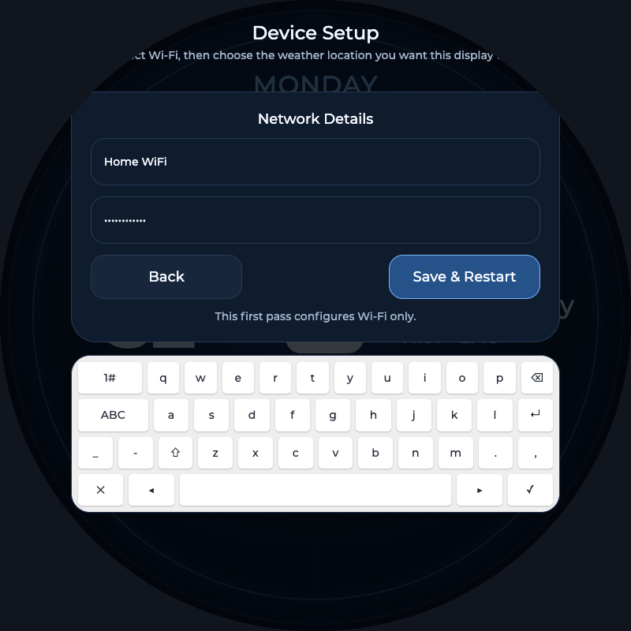
mockups/screens/password-keyboard.png
