SDupuie/esp32-weather-alarm-clock/mockups/screens/settings-bottom.png

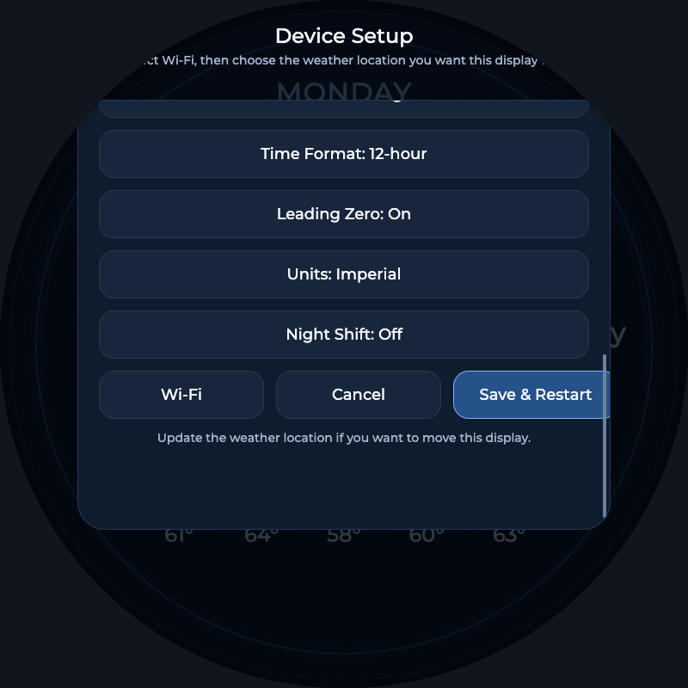
mockups/screens/settings-bottom.png
