SDupuie/esp32-weather-alarm-clock/mockups/screens/settings.png

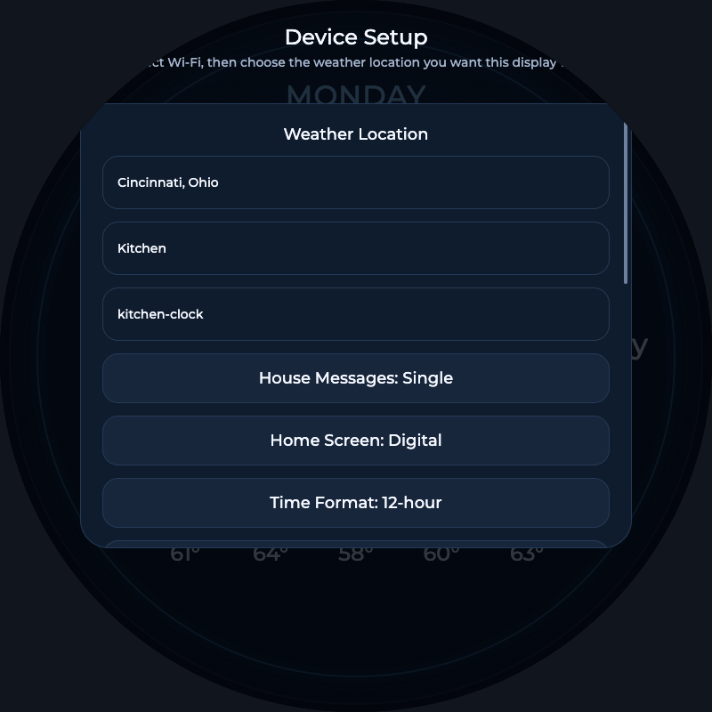
mockups/screens/settings.png
