SDupuie/esp32-weather-alarm-clock/mockups/screens/unread.png

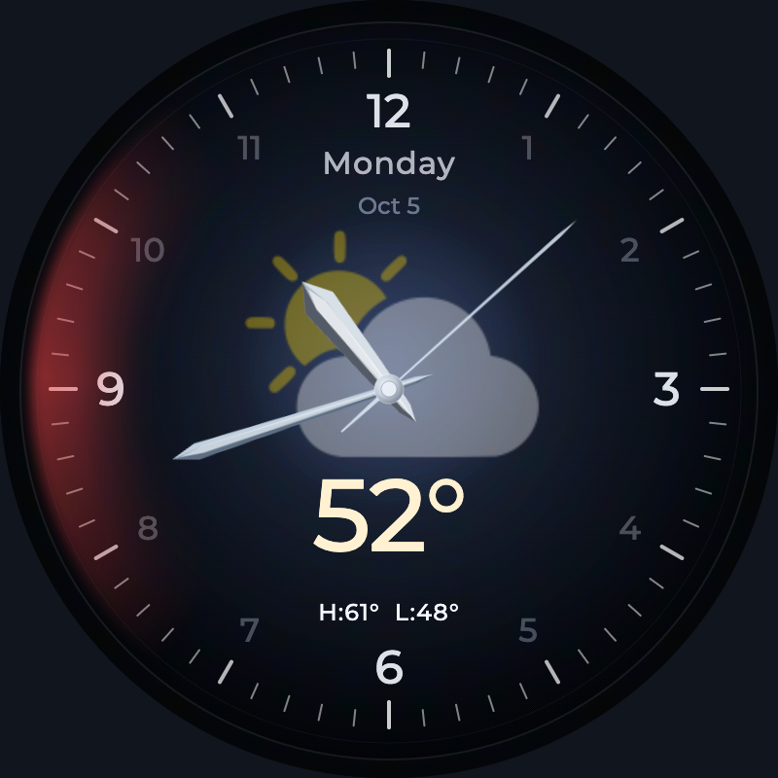
mockups/screens/unread.png
