SDupuie/esp32-weather-alarm-clock/mockups/screens/wifi.png

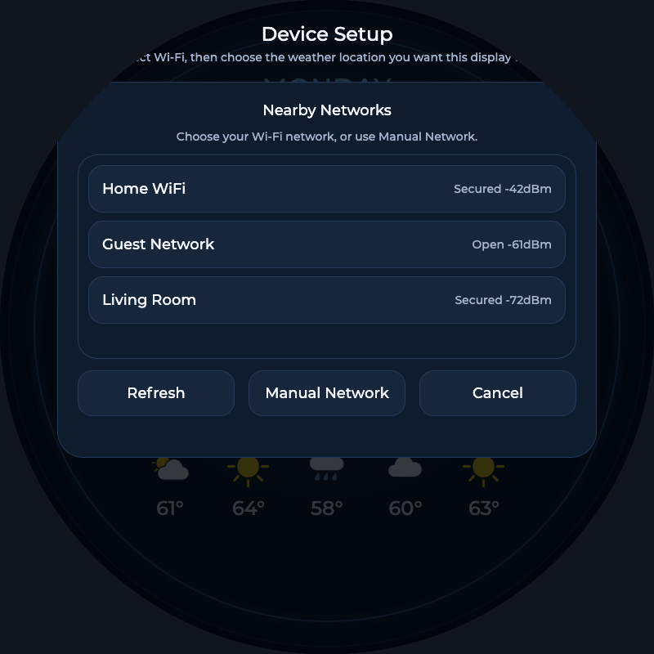
mockups/screens/wifi.png
