SDupuie/esp32-weather-alarm-clock/docs/orbit-case/cad/Orbit-Case-Main-Body-Front-Down.stl

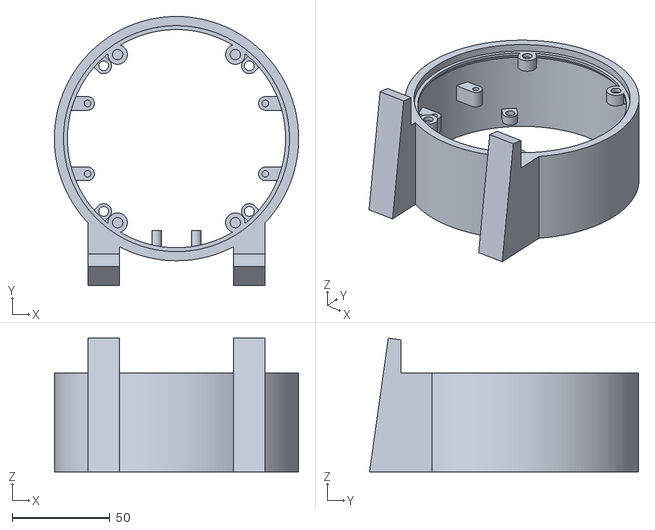
[picture p67: CAD file, 2026-10-21]
docs/orbit-case/cad/Orbit-Case-Main-Body-Front-Down.stl
125.0 x 137.6 x 68.5
