SDupuie/esp32-weather-alarm-clock/docs/orbit-case/cad/Orbit-Case-Main-Body.step

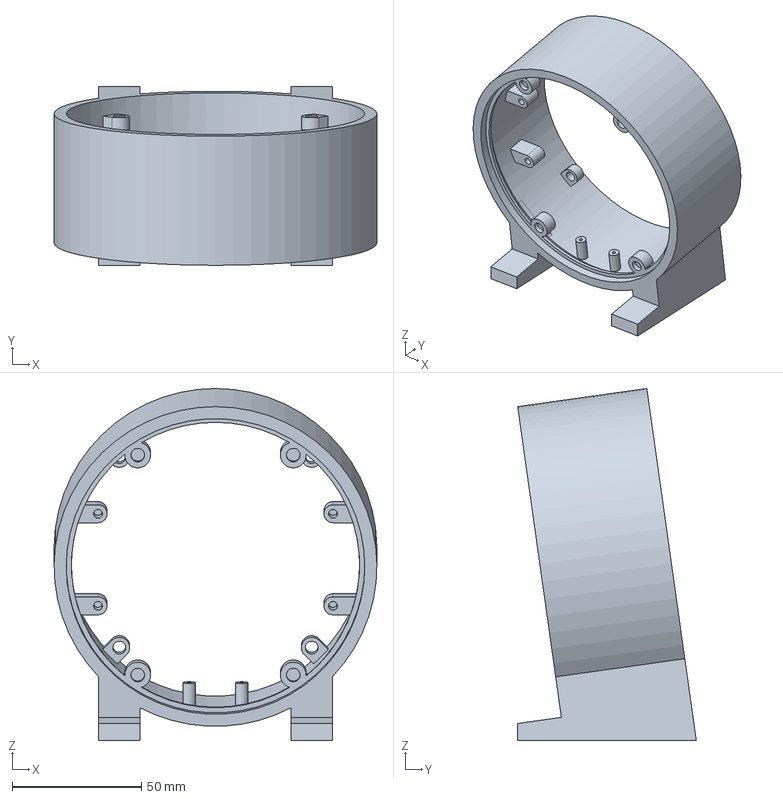
[picture p68: CAD file, 2026-10-21]
docs/orbit-case/cad/Orbit-Case-Main-Body.step
125.0 x 69.2 x 136.3 mm
