SDupuie/esp32-weather-alarm-clock/docs/orbit-case/cad/Orbit-Case-Back-Cover.step

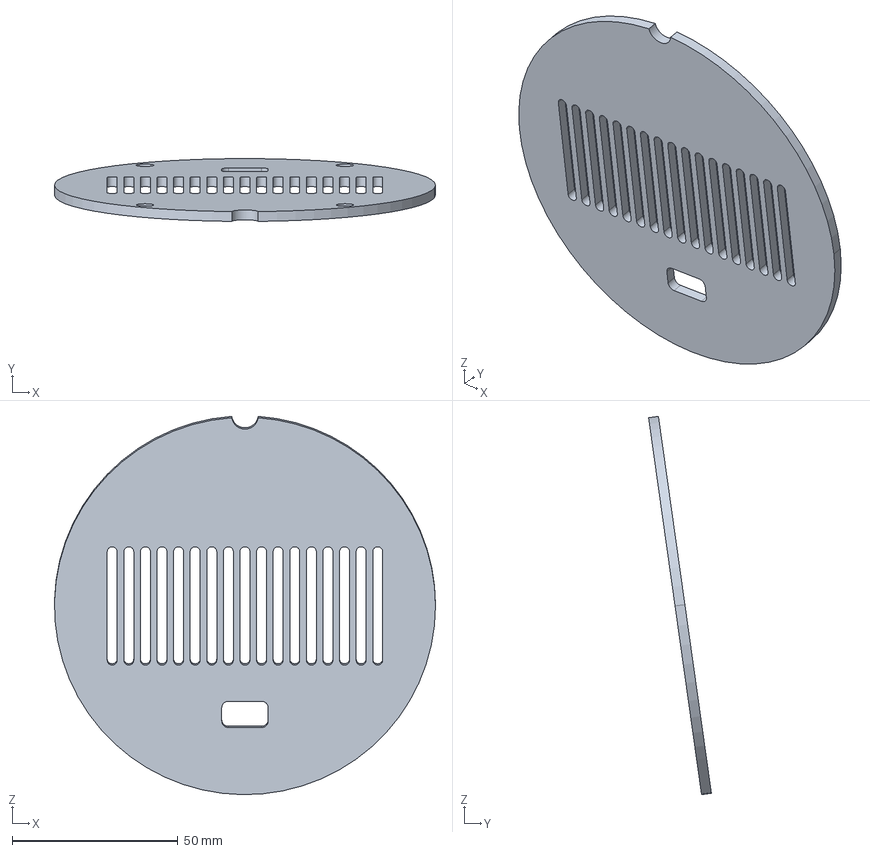
[picture p70: CAD file, 2026-10-21]
docs/orbit-case/cad/Orbit-Case-Back-Cover.step
114.8 x 18.9 x 114.0 mm
