SDupuie/esp32-weather-alarm-clock/docs/orbit-case/cad/Orbit-Case-Back-Cover-Outer-Face-Down.stl

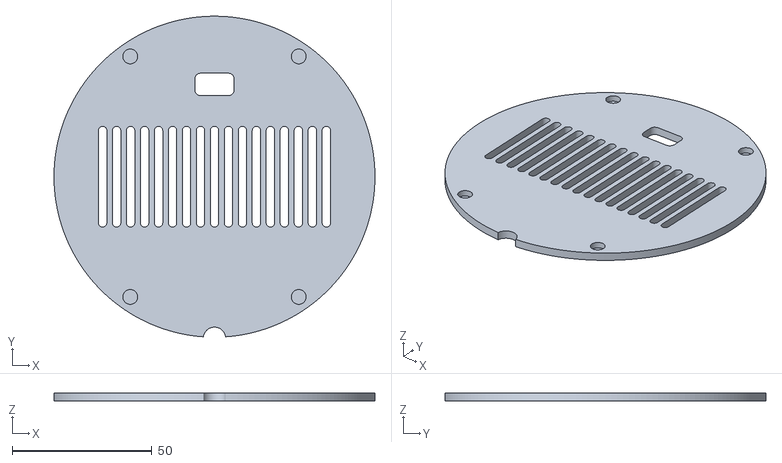
[picture p71: CAD file, 2026-10-21]
docs/orbit-case/cad/Orbit-Case-Back-Cover-Outer-Face-Down.stl
114.8 x 114.7 x 3.00
