SDupuie/esp32-weather-alarm-clock/(list of files, cad)

Other CAD files:
docs/orbit-case/cad/Orbit-Case-Back-Cover-Outer-Face-Up.stl
