SDupuie/esp32-weather-alarm-clock/docs/orbit-case/Orbit-Back-Cover-Installed-Mockup.png

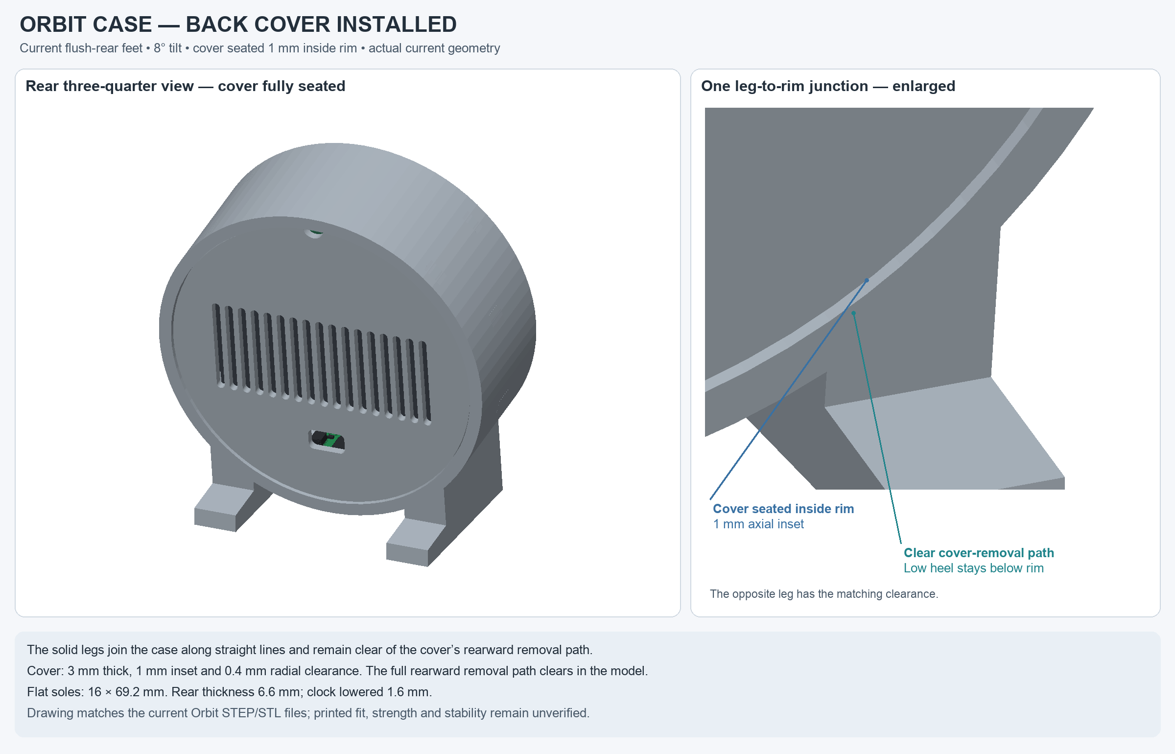
docs/orbit-case/Orbit-Back-Cover-Installed-Mockup.png
