SDupuie/esp32-weather-alarm-clock/docs/orbit-case/Orbit-Front-Down-Print-Orientation.png

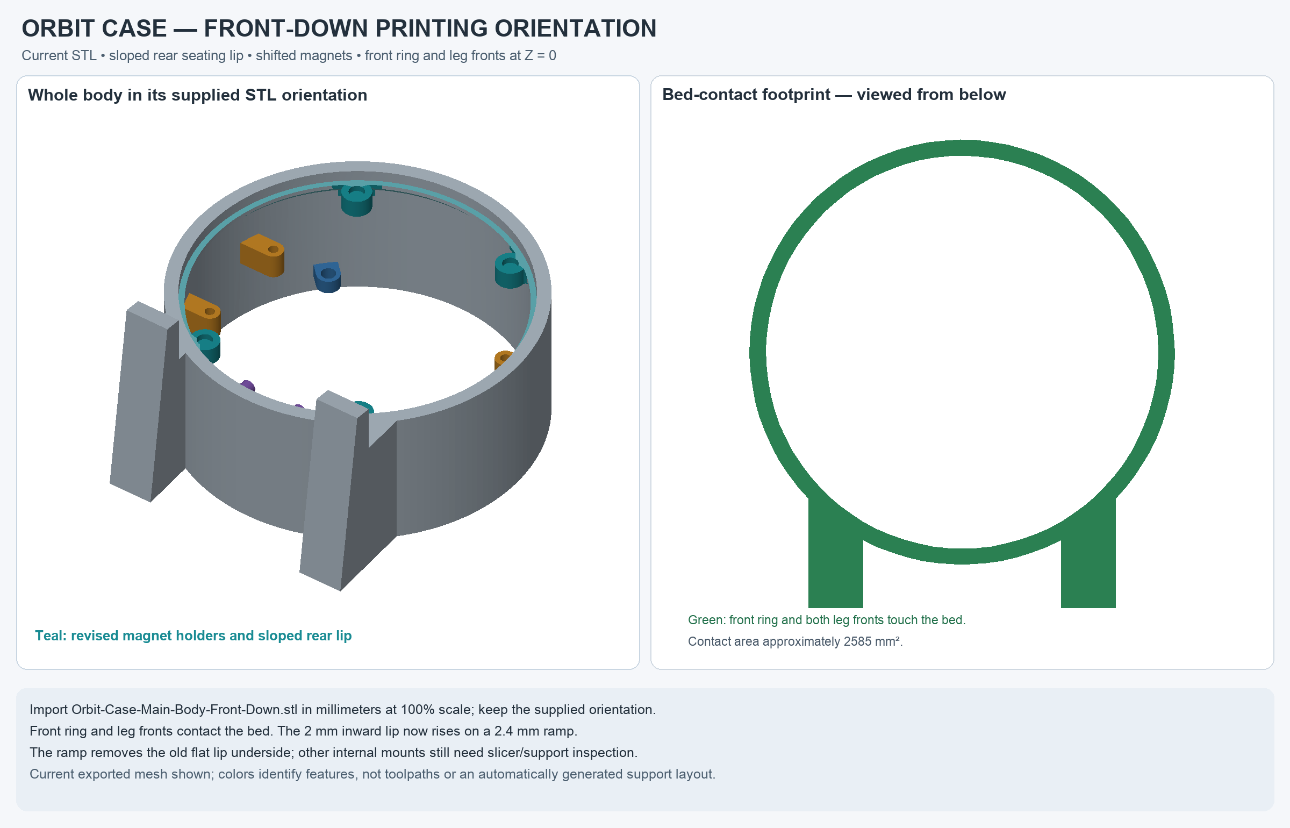
docs/orbit-case/Orbit-Front-Down-Print-Orientation.png
