SDupuie/esp32-weather-alarm-clock/mockups/screens/alarm-device-setup-night.png

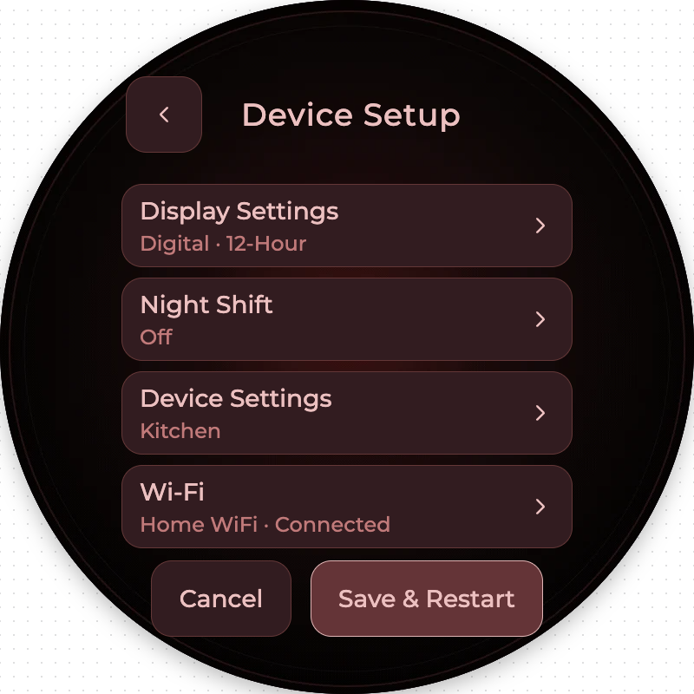
mockups/screens/alarm-device-setup-night.png
