SDupuie/esp32-weather-alarm-clock/mockups/setup-overview.png

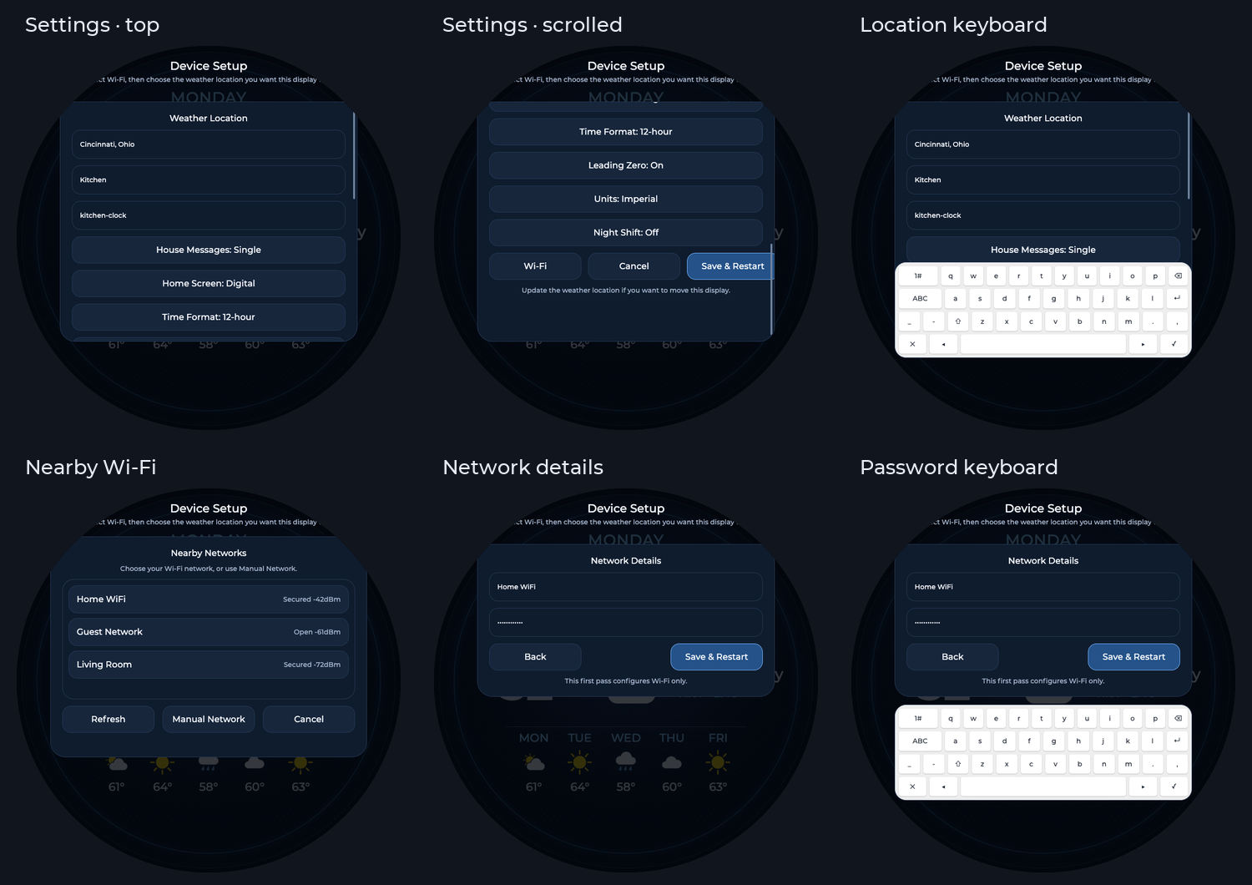
mockups/setup-overview.png
