SDupuie/esp32-weather-alarm-clock/mockups/screens/alarm-network-validation.png

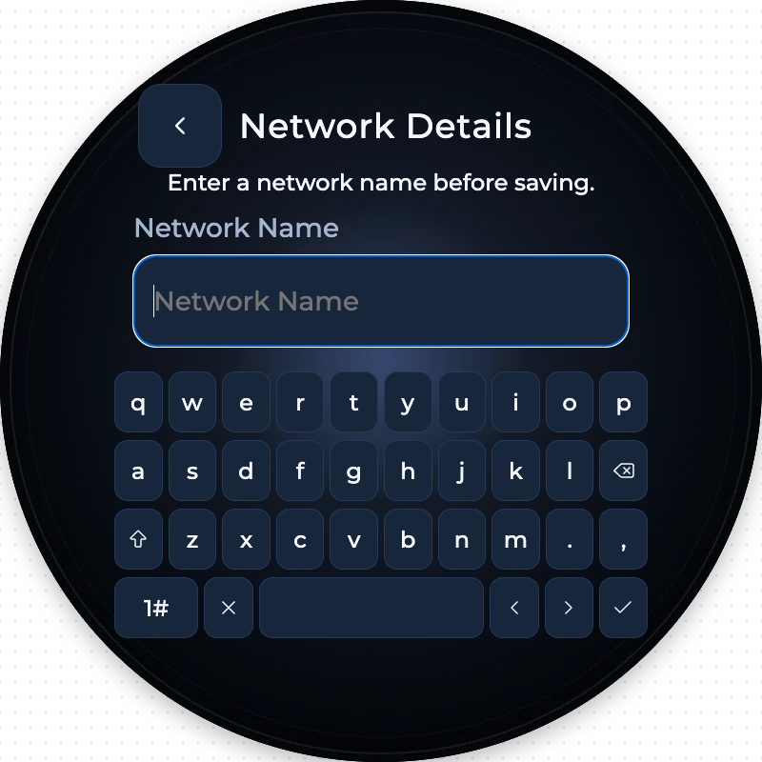
mockups/screens/alarm-network-validation.png
