SDupuie/esp32-weather-alarm-clock/tests/data/radar-six-frame/expected-frame-1.png

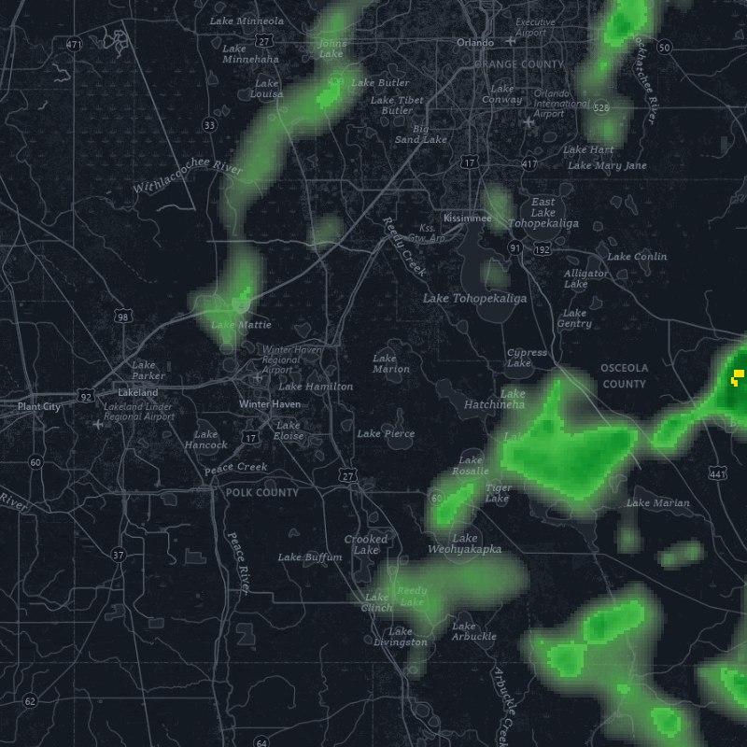
tests/data/radar-six-frame/expected-frame-1.png
