SDupuie/esp32-weather-alarm-clock/tests/data/radar-six-frame/expected-frame-2.png

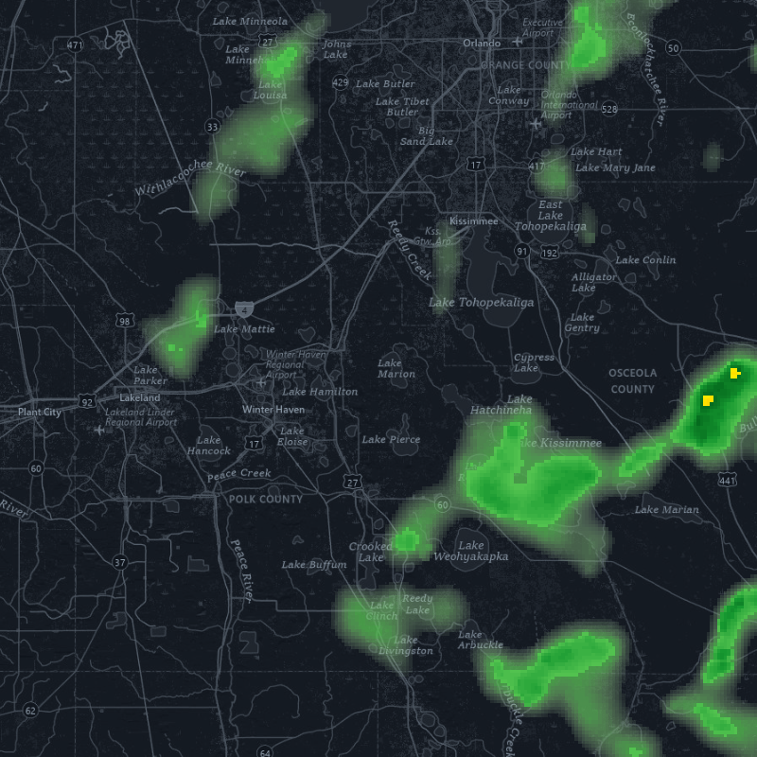
tests/data/radar-six-frame/expected-frame-2.png
