SDupuie/esp32-weather-alarm-clock/tests/data/radar-six-frame/expected-frame-3.png

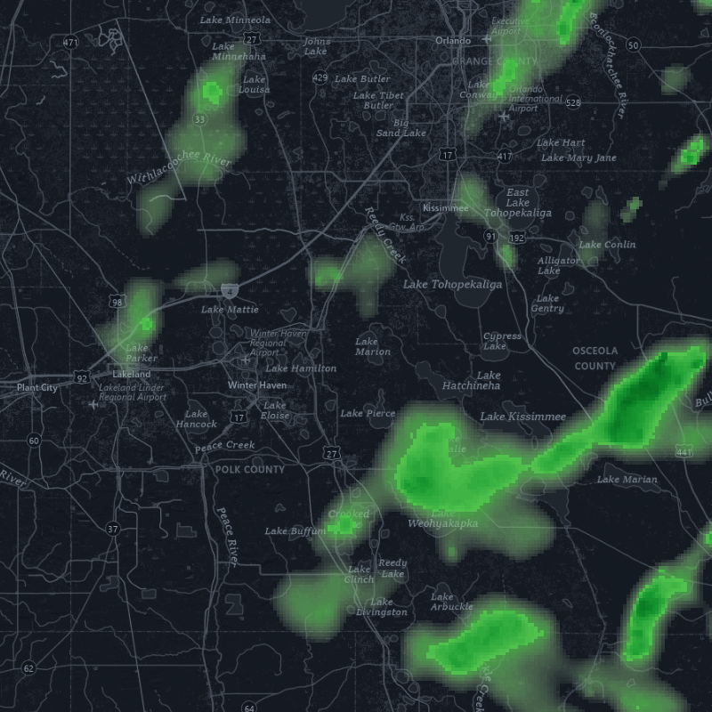
tests/data/radar-six-frame/expected-frame-3.png
