SDupuie/esp32-weather-alarm-clock/tests/data/radar-six-frame/expected-frame-4.png

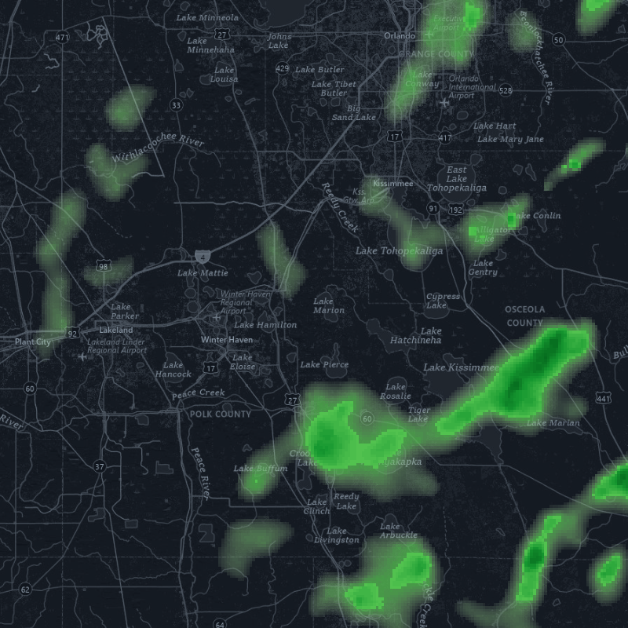
tests/data/radar-six-frame/expected-frame-4.png
