SDupuie/esp32-weather-alarm-clock/tests/data/radar-six-frame/frames/frame-0-1792413000-z7-34-53-512-smooth.png

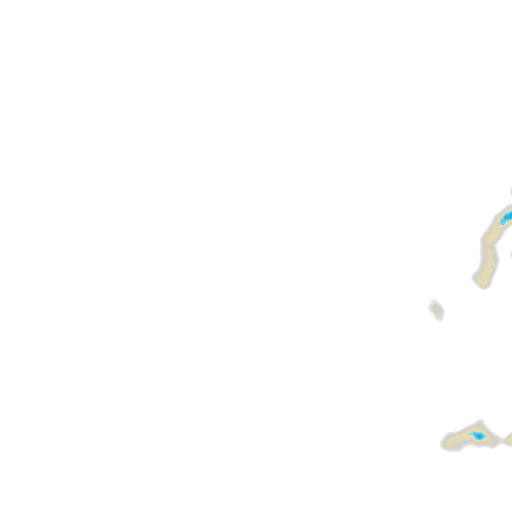
tests/data/radar-six-frame/frames/frame-0-1792413000-z7-34-53-512-smooth.png
