SDupuie/esp32-weather-alarm-clock/tests/data/radar-six-frame/frames/frame-1-1792413600-z7-35-53-512-smooth.png

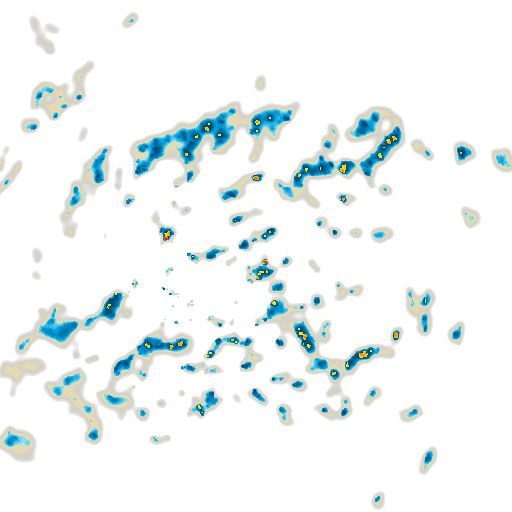
tests/data/radar-six-frame/frames/frame-1-1792413600-z7-35-53-512-smooth.png
