SDupuie/esp32-weather-alarm-clock/tests/data/radar-six-frame/frames/frame-2-1792414200-z7-35-53-512-smooth.png

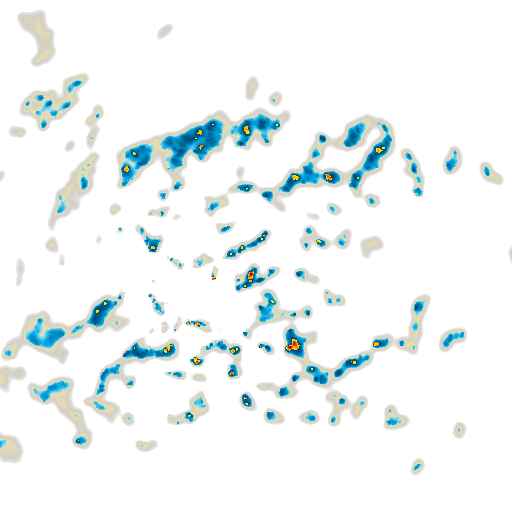
tests/data/radar-six-frame/frames/frame-2-1792414200-z7-35-53-512-smooth.png
