SDupuie/esp32-weather-alarm-clock/tests/data/radar-six-frame/frames/frame-4-1792415400-z7-35-53-512-smooth.png

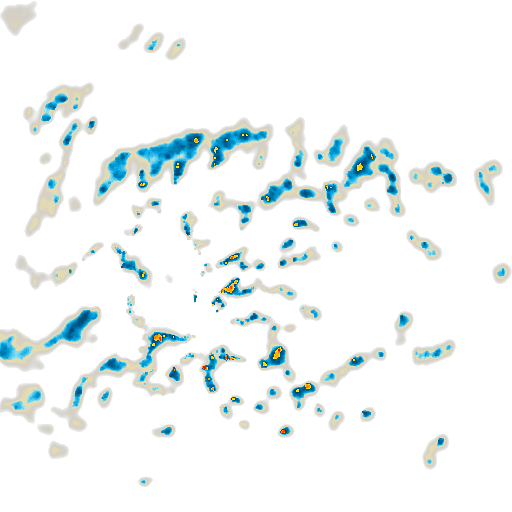
tests/data/radar-six-frame/frames/frame-4-1792415400-z7-35-53-512-smooth.png
