SDupuie/esp32-weather-alarm-clock/tests/data/radar-six-frame/frames/frame-5-1792416000-z7-35-53-512-smooth.png

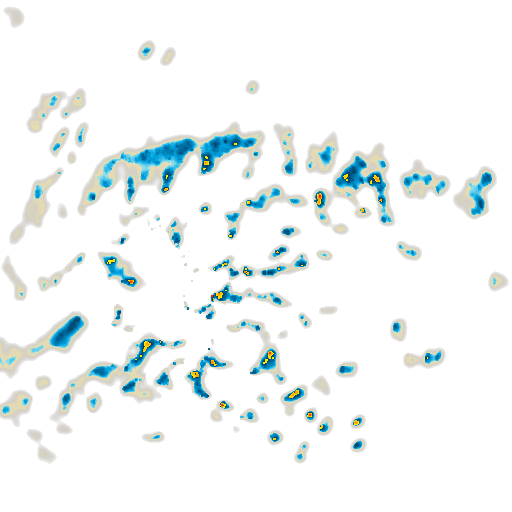
tests/data/radar-six-frame/frames/frame-5-1792416000-z7-35-53-512-smooth.png
