SDupuie/esp32-weather-alarm-clock/tests/data/radar-six-frame/frames/usgs-background-800.png

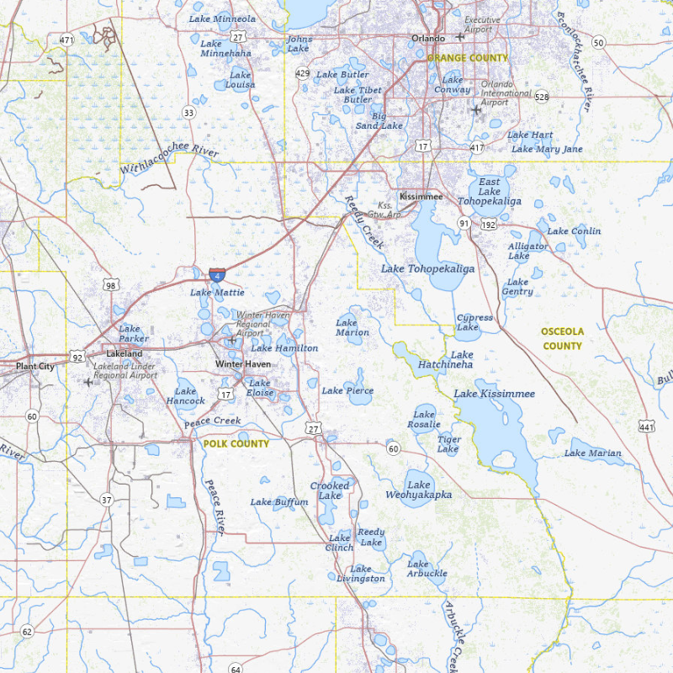
tests/data/radar-six-frame/frames/usgs-background-800.png
