SDupuie/esp32-weather-alarm-clock/targets/esp32-p4/tests/test_alarm_schedule.c

#include <assert.h>
#include <stdio.h>
#include <stdlib.h>
#include <string.h>

#include "alarm_schedule.h"

/* Expected times below are UTC, calculated from the stated POSIX offsets and
 * calendar dates. They do not call local conversion to create expectations. */
static time_t utc(const char *text)
{
  int year, month, day, hour, minute, second;
  assert(sscanf(text, "%d-%d-%d %d:%d:%d", &year, &month, &day,
    &hour, &minute, &second) == 6);
  struct tm date = {.tm_year = year - 1900, .tm_mon = month - 1,
    .tm_mday = day, .tm_hour = hour, .tm_min = minute, .tm_sec = second};
  return timegm(&date);
}

typedef struct {
  const char *zone;
  unsigned hour, minute, days;
  const char *now, *previous, *next;
  int previous_date, next_date;
} case_t;

static const case_t cases[] = {
  /* Daily: strict next, equality, and nonzero seconds. */
  {"UTC0", 7, 0, 127, "2026-10-12 06:59:59", "2026-10-11 07:00:00", "2026-10-12 07:00:00", 20261011, 20261012},
  {"UTC0", 7, 0, 127, "2026-10-12 07:00:00", "2026-10-12 07:00:00", "2026-10-13 07:00:00", 20261012, 20261013},
  {"UTC0", 7, 0, 127, "2026-10-12 07:00:59", "2026-10-12 07:00:00", "2026-10-13 07:00:00", 20261012, 20261013},
  /* Monday-Friday, Sunday bit 0, Saturday bit 6, and a sparse mixed mask. */
  {"UTC0", 7, 0, 62, "2026-10-11 12:00:00", "2026-10-09 07:00:00", "2026-10-12 07:00:00", 20261009, 20261012},
  {"UTC0", 7, 0, 1, "2026-10-11 07:00:00", "2026-10-11 07:00:00", "2026-10-18 07:00:00", 20261011, 20261018},
  {"UTC0", 7, 0, 64, "2026-10-11 07:00:00", "2026-10-10 07:00:00", "2026-10-17 07:00:00", 20261010, 20261017},
  {"UTC0", 23, 59, 10, "2026-10-13 00:00:00", "2026-10-12 23:59:00", "2026-10-14 23:59:00", 20261012, 20261014},
  /* Year boundary, leap day, century non-leap rule, and arbitrary minute. */
  {"UTC0", 0, 0, 127, "2026-01-01 00:00:00", "2026-01-01 00:00:00", "2026-01-02 00:00:00", 20260101, 20260102},
  {"UTC0", 0, 0, 1, "2026-01-01 00:00:00", "2025-12-28 00:00:00", "2026-01-04 00:00:00", 20251228, 20260104},
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
