SDupuie/esp32-weather-alarm-clock/(commit log)

2026-10-08 Establish development policy and ESP32 build/test workflow
2026-10-09 Establish reviewed weather alarm clock implementation baseline
    Consolidate approved behavior and architecture, add the combined UI reference and project guidance, and retire superseded specifications.
    Document current setup and usage, reuse the installed ESP-IDF environment, and acknowledge the displayed message by ID.
    Validated native forecast, location, conditions and acknowledgment checks; ESP-IDF 5.5.5 firmware build passes. Hardware verification remains pending.
2026-10-09 Consolidate ESP32 application and close reviewed cleanup
    Group application owners, UI and native tests in the approved source tree.
    Retire the unsupported Pi application and obsolete build/asset machinery.
    Integrate RTC time and notices, preserve current Night Shift decisions, and
    correct connectivity, weather-date handling and message handoffs/retries.
    Preserve browser message management and simplify unused interfaces/state.
    Update architecture, work status and build/test guides. The inherited
    special-character clock-ID polling issue remains unchanged.
    Validation: 14 native tests; four message check groups; five forecast,
    three location and 30 conditions cases; ESP-IDF 5.5.5 firmware bui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
2026-10-10 Finish Night Shift startup and clock-screen rendering
    Remember effective Night appearance and advance configured brightness after display readiness. Move clock drawing into its private owner, fit digital Night time, and share the unavailable-time surface while preserving navigation and notices. Extend native checks and documentation; record board availability with hardware verification pending.
2026-10-10 Fix touch freeze and improve settings usability
    Skip backup-clock calendar reads after failed initialization, preserving the existing retry schedule and standard BSP display startup. Cancel interrupted presses after returned touch-read errors.
    Center the settings keyboard, enforce a 20% brightness minimum and 30% Night default, and update native checks, mockups and documentation with board-test evidence.
2026-10-11 Match settings menus and approved clock screens to mockups
    Rework settings navigation, controls, keyboards and Wi-Fi status using the approved layouts. Apply the approved clock/weather presentation changes, larger Digital Night time and centered Forecast columns.
    Update architecture, user guides and work records. Defer the inherited Shared Device ID issue without changing messaging behavior.
    Validation: 17 native checks passed; ESP-IDF 5.5.5 build passed with 24% application space free. Recorded board checks cover menu interaction and approved screen fit. Precise rendering and exceptional hardware states remain pending.
2026-10-13 Add Visual Crossing weather and reviewed configuration updates
    Implement keyed Visual Crossing requests, shared condition mappings and approved
    daily forecast rules. Add masked, retained API-key editing and activation checks
    to ordinary Weather saves, with bounded in-memory quota recovery. Preserve the
    immediate Alarm On/Off switch and existing alarm restart recovery.
    Use PSRAM for JSON allocations, release request scratch before decoding, increase
    the existing UI task stack, and enable the SDK flash-address setting needed by
    the larger image. Record the measured checks and limits on crash causation.
    Include approved weather artwork and fixtures, Radar/Sound Machine mockups and
    behavior re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
2026-10-15 Complete Sound Machine playback and approved notification updates
    Add recorded and generated Sound Machine playback, sleep timing, live controls and clock shortcuts. Retain the verified audio, memory and drawing corrections and prepared browser installer bundle.
    Apply the approved waiting, weather-age, stale-notice and log-only diagnostic decisions while preserving alarm actions and restart recovery. Update the official visual reference, documentation and work record.
    Validation: 44 native checks, weather parity checks and ESP-IDF 5.5.5 build passed. The application was hash-verified on the board, with 26 autonomous display-state checks and unchanged preferences and alarm recovery record.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
2026-10-17 Refresh documentation and record attached RTC verification
2026-10-19 Retire Conditions and optimize weather artwork and Radar
    Remove the Conditions renderer and its exclusive assets and calculations while preserving current storm behavior. Regenerate weather icons and Analog hands as RGB565A8, retain original artwork and placement, and use smoothed 512px RainViewer tiles.
    Record approved NWS and menu design decisions as pending firmware work. Remove the superseded weather generator and document its verified replacement. Native, fixture, messaging, firmware build and bounded device evidence are recorded in docs/work.md.
2026-10-19 Add NWS alerts, Radar playback, and reviewed ownership cleanup
    Replace threshold storm checks with independent NWS watches and warnings,
    retained alerts and dismissals, and reviewed sound controls. Add bounded
    six-frame Radar playback and the approved clock and settings presentation.
    Consolidate weather execution and retained state in its existing owner,
    preserve browser message recipients through destination refresh failures,
    and remove the reviewed unused interfaces, data and generator leftovers.
    Update the architecture, official mockup, user guidance and work record.
    Validation: 49 native checks, all six message/browser groups, 53 forecast
    and three location fixtures, syntax checks and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
2026-10-21 Consolidate ESP32-P4 project layout and documentation
    Move the single-target firmware, assets, generators and native checks to the repository root. Keep reusable Radar inputs with tests and generate temporary SVG intermediates on demand.
    Include the reviewed message-ID handling, clock/alarm layout, weather attribution, slider controls and expanded weather artwork. Refresh the README, build guide, architecture, weather reference, license notices and Orbit case materials. Remove the retired work log and exclude local editor settings.
    Validation: the completed adversarial review found no actionable findings. All 49 native checks, weather/location checks, message/browser checks, six-frame Rada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
2026-10-21 Fix settings navigation and align menu behavior with mockups
    Return clock-entry Alarm Save to the clock while preserving pending Snooze and Dismiss navigation. Start Manual Network with fresh draft credentials and open missing Visual Crossing key entry automatically.
    Align mockup Back, Cancel and input limits. Update documentation, include the verified README case-surface image correction, and record the accepted long-message display limitation.
    Validation: 49 native tests passed, ESP-IDF 5.5.5 build passed, mockup action and syntax checks passed, application flash verified and normal startup observed. Physical Alarm Save return confirmed.
2026-10-21 Release v1.0.0 — Weather alarm clock for the Waveshare ESP32-P4
    ### Features
    - Analog and digital clock faces with Day and Night appearances.
    - One-time and repeating alarms with sound previews, Snooze, Slide to Dismiss and restart recovery.
    - Sound Machine with nine looping recordings, three generated noises, independent volume and sleep timers.
    - Current weather and five-day forecasts from Open-Meteo or Visual Crossing.
    - Full-screen U.S. Radar with a 75-mile coverage diameter and six-frame playback, plus official NWS watches and warnings for covered locations.
    - Night Shift with fixed or sunset-to-sunrise scheduling, separate Day/Night brightness and gradual transitions.
    - Optional bat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
2026-10-25 Release v1.1.0 — Clock controls, screen timers and display refinements
    - Start or stop Sound Machine directly from either clock face's speaker icon using the saved sound, volume and sleep timer.
    - Return Settings, Display, Alarm and Sound Machine menus to the clock after 15 seconds without touch. Device Setup and its menus stay open. Unsaved edits are discarded; applied choices, playback and submitted saves continue.
    - Return Messages, Forecast and Radar to the clock after 60 seconds without touch, without marking messages read.
    ### Changed
    - Center the time digits independently of AM/PM on Day Digital and Ringing, Snoozed and Dismissed screens.
    - Enlarge the main Forecast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
